gytkk/keycult-ball/docs/project-context.md

# 프로젝트 맥락과 설계 결정

작성일: 2026-10-29. 현재 저장소가 후속 작업의 기준 위치다. 대화 원문을 옮긴 문서가 아니라, 설계에 필요한 요구사항·근거·남은 질문만 정리했다.

현재 보유 제품은 사용자 확인 기준 NovelKeys 최신 판매 버전의 No.1/60 WK이며 WT60-A와 호환된다. PCB와 GH60의 호환성도 사용자 확인 완료로 두고 재확인 작업에서 제외한다. 정확한 리비전과 기존 공개 보강판 CAD의 실물 적합성은 아직 확인되지 않았다. 사용자는 외부 트랙볼을 이미 충분히 사용했으며 이번 프로젝트의 목적은 G/H 사이 중앙 통합이다. 외부 별도 장치는 후보에서 제외한다. 34mm Keyball은 현재 생성된 예비 배치의 기준이며 고정 요구사항은 아니므로 작은 볼과 터치패드도 중앙 통합 후보로 검토한다. [실현 가능성과 대안 조사](feasibility.md)는 후보 비교이며 최종 장치와 새 배열은 아직 선택하지 않았다.

## 1. 요구사항과 작업 경계

| 항목 | 현재 요구사항 / 경계 |
|---|---|
| 보존 대상 | Keycult No.1/60 케이스. 새 케이스 구멍·절삭 없이 장착하는 것이 목표 |
| 교체 대상 | 중앙 통합을 위한 PCB와 플레이트 교체 |
| 배열 | 1u=19.05mm 직교 배열, 5행을 우선 검토. 문자 순서는 QWERTY |
| 포인팅 | G/H 사이 중앙 통합 필수. 현재 예비 배치는 34mm Keyball 기준이며 작은 볼과 터치패드도 검토 가능. 트랙볼을 사용하면 볼과 센서의 상대 광학 위치 유지 |
| 연결·펌웨어 | 유선 USB, QMK 기반 키보드+포인팅 장치. 외부 별도 장치와 무선은 현재 범위 밖 |
| 현재 산출물 | 출처 있는 예비 배치, 키 중심 좌표, 평면/단면 그림, 종이 검증 및 [65키·62키 KiCad 회로·PCB 초안](../design/pcb/README.md), 각 배열의 BOM·핀맵·실제 검사 결과 |
| 아직 하지 않은 일 | 최종 회로/PCB·제조 검증, 가공용 플레이트, 검증된 펌웨어 포팅, 구매·제조·케이스 가공 |

## 2. 결정과 이유

1. **15u·중앙 3u·65키를 추천 기준안으로 유지하고 62키 옵션을 별도로 비교**한다. 하단 중앙 1u M1/M3/M2를 1.5u M1/M2로 바꾸고 M3 물리 키를 제거한다. 두 중심은 mm 단위로 M1=(-14.2875,38.1), M2=(14.2875,38.1)이며 명목 너비 합계는 3u다. 기준안은 좌우 6열씩과 중앙 3열을 배치하고 가운데 3×3칸을 비워 50mm 임시 조립 영역과 수·문자·수정키를 유지한다. `layout.json`의 `rear_clearance`는 상단 중앙 Vol-/Mute/Vol+만 제거해 중앙 빈 명목 영역을 3열 × 4행, 57.15 × 76.20mm로 늘린다. 볼 지름 34mm와 중심 `(0, 0)`, G/H x=±38.10mm, 하단 1.5u M1/M2와 나머지 키는 그대로다. 추가한 뒤쪽 19.05mm는 센서·배선, 재료를 남긴 지지 브리지와 넓은 체결 간격을 검토하기 위한 공간이다. 키 제거 자체는 강성 향상을 보증하지 않으며 전체 직사각형 절개는 오히려 강성을 낮출 수 있다. 50×50mm 임시 예약 영역과 미확정 수직 공간은 바꾸지 않는다.
2. **14u·중앙 2u·64키는 비교만 하고 보류**한다. Ø34 볼 자체는 들어가지만, 홀더/센서/나사까지 포함한 수납 근거가 없다. 50mm 예약 영역은 키캡과 5.425mm 겹친다. 실물의 높이별 외곽이 더 작으면 재검토할 수 있다.
3. **현재 생성된 예비 배치는 Keyball을 기준으로 유지**한다. 최초 검토 대상인 34mm 시스템이며 공개 조립 가이드·센서 자료를 활용할 수 있다. 공개된 센서 기판 외곽과 실제 홀더 외피는 다른 정보다. 원형 Ploopy Nano/Mini는 38.10mm, Classic은 44.45mm여서 34mm 드롭인 대체품이 아니다. Charybdis는 같은 34mm지만 별도 장착 설계가 필요하다. 제품별 센서·지지 구조·라이선스는 [별도 비교](alternatives-and-licenses.md)에 기록한다. 중앙 통합이 가능한 소형 장치는 [대안 조사](feasibility.md)에서 비교하며, 기존 산출물 유지가 최종 장치 선택을 뜻하지 않는다.
4. **볼+센서는 같은 강체에 고정**한다. 우선 새 플레이트에 하나의 모듈로 장착하고 중앙 보강을 검토한다. 공간·강성 결과에 따라 기존 케이스 체결점을 쓰는 가역 브래킷도 검토한다. 볼은 케이스, 센서는 휘는 플레이트에 따로 고정하지 않는다.
5. **GH60 공개 KiCad 도면을 출발점으로 새 PCB를 설계한다.** 보강판이 케이스에 결합하고 PCB는 스위치를 통해 지지되므로, WT60-A와의 작은 외곽 치수 차이만으로 GH60 기반 설계를 배제하지 않는다. Poker2 규격 WT60-D가 USB-C 제거와 JST 커넥터 추가 후 No.1/60에 장착된다는 제품 설명을 근거로 삼는다. WT60-A의 정확한 PCB CAD 확보를 설계 시작의 선행 조건으로 두지 않는다. 사용할 GH60 파일과 호환 근거, 도터보드 연결 조건은 [PCB 설계 출발점](../design/preliminary/design.md#pcb-설계-출발점)에 기록한다. 최종 외곽과 중앙 개구, 부품 배치 및 제조 데이터는 FreeCAD에서 공식 STEP와 실측 모듈의 기구 스택을 대조한 뒤 확정하며, 예비 SVG를 제조 DXF로 바꿔 바로 발주하지 않는다.

실측 전에 회로도, 키 매트릭스, 스위치 배치와 주요 회로 배선 초안을 진행한다. 구현 순서, RP2040 등 초안의 우선안과 단계별 완료 기준은 [PCB 구현 계획](pcb-implementation-plan.md)을 따른다. 실물 확인은 GitHub 이슈 #1부터 #6에서 관리하며, 기구와 인터페이스가 미확정인 상태를 제조 준비 완료로 보고하지 않는다.

65키 KiCad 원본은 `design/pcb/keycult65.*`, 62키 원본은 `design/pcb/62/keycult62.*`에 둔다. 공통 MCU·전원 회로는 이전 초안보다 왼쪽으로 76.2mm(4피치) 이동해 62키 뒤쪽 중앙 빈 영역을 피한다. 두 배열 모두 하단 SW59/D59를 제거하고 SW58/SW60의 중심을 옮기며, 다른 reference 번호는 유지한다. 62키에서는 SW7-SW9와 D7-D9도 제거한다. COL6과 COL8은 하단 키에 연결되고, 62키의 COL7은 키가 없으므로 GP16을 회로도에서 NC로 표시한다. 공통 15열 GPIO 순서는 유지하고 펌웨어에서는 해당 열을 KC_NO로 둔다. 스위치를 장착하지 않는 것은 전기적으로 가능하지만, 이전 PCB에는 해당 영역 아래에 공통 회로가 있으므로 기존 PCB를 잘라 공간을 확보해서는 안 된다.

65키 PCB의 부품·구리 예약 영역은 50 x 50mm다. 62키 PCB는 명목 빈 영역을 작업 외곽에 맞춰 잘라 PCB 좌표 x=151.425..208.575mm, y=52.7..128.575mm의 57.15 x 75.875mm를 예약한다. PCB 원점 대응은 배열 `(0,0)`이 `(180,100)mm`이며 +Y는 하단 방향이다. 이 영역은 홀더 치수나 중앙 Edge.Cuts 개구가 아니며, 기존 예비 도면의 50mm 임시 조립 영역과 수직 공간 가정은 유지한다. 센서는 정확한 사양을 알 수 없으므로 논리 패드로 남긴다. 검사 상태는 [65키 보고서](../design/pcb/reports/validation.json)와 [62키 보고서](../design/pcb/62/reports/validation.json)를 기준으로 한다.

USB는 [WT 호환 및 UDB 리비전별 조사](../design/pcb/sources.md#usb-daughterboard-evidence)와 2026-10-30 사용자 승인에 따라 UDB C5-JSH를 그대로 사용하는 가정으로 설계한다. 이는 보유 Keycult 순정 도터보드의 리비전이나 회로를 실측으로 확인했다는 뜻이 아니다. DRAFT E도 외부 조립체 DB1을 회로도에만 표시하며 메인 PCB footprint를 두지 않는다. C5-JSH의 CC 5.1kΩ 저항 2개, TPD4E05U06 ESD 보호, ASMD1206-150 PTC, SMF6.0A TVS 및 실드의 GND 직결을 외부 보드가 담당한다. 메인 PCB의 F1 500mA와 USB 27Ω 직렬 저항, 기존 공통 부품 배치를 유지하고 하단 1.5u M1/M2 좌표에 맞춰 매트릭스를 다시 배선한다. J1 측 USB 배선 규칙과 접지 귀환 경로도 적용한다.

두 PCB의 J1은 JST SM04B-SRSS-TB(LF)(SN)이며 핀은 1=VBUS_USB(외부 PTC 이후), 2=D-, 3=D+, 4=GND다. 케이블은 번호 기준 1:1 연결이다. J1은 하단면에서 왼쪽을 향하며 원점은 PCB `(40.6,112.0)mm`다. 이 위치는 직교 배열의 간섭을 피한 임시 배치로, WT60-A에서 실측한 위치가 아니다. 필요한 길이의 케이블을 구할 수 있으므로 기존 케이블의 도달 거리는 설계 제약에서 제외한다. 커넥터 체결·삽입 공간, 케이스 통로·굴곡 공간과 하부 높이, 실제 부하·돌입전류 및 직렬 퓨즈의 전압 강하, USB 신호 품질은 확인해야 한다. 보유 순정 도터보드의 모델 확인을 이 가정에 따른 회로·PCB 설계의 선행 조건으로 두지 않는다.

2026-10-30 [실물 없이 수행한 전기 검토](../design/pcb/README.md#power-and-usb-desk-review)는 전체 3.3V 부하 150mA, 그중 센서 40mA를 임시 설계 예산으로 둔다. 부품 최대 소비전류나 실제 사용 가능한 전류를 보증한 값은 아니며 센서가 5V 모듈이면 별도 계산한다. DRAFT E는 JLC04161H-7628 후보의 구리·유전체 모델을 CAD에 명시하고, 긴 USB 구간을 In2.Cu에서 F.Cu로 옮겨 In1.Cu 접지를 참조하도록 한다. J1 측 데이터 배선은 선폭 0.29mm, 최소 가장자리 간격 0.2mm를 사용하며 B.Cu에는 짧은 탈출 배선만 둔다. 접지 비아와 B.Cu 접지면을 추가하고 In1.Cu 상단 경계를 확장한다. [적용한 USB 배선과 검토 한계](../design/pcb/README.md#usb-routing-findings)를 따르며, 이 모델은 제조사 승인 stackup이나 임피던스 검증 완료를 뜻하지 않는다.

## 3. 확인된 값, 유도한 값, 가정한 값

2026-10-30 [로컬 FreeCAD 보강판 초안](../design/preliminary/design.md#로컬-freecad-보강판-초안)은 공식 NoLeaf의 외곽을 유지하면서 65키·62키 PCB의 스위치 중심에 맞춰 재생성한다. 중앙 지름 40mm 개구, 48 x 48 x 3mm 프레임과 네 점의 M2 체결 검토는 자체 설계 가정이며 실물 Keyball 홀더 치수가 아니다. 62키안은 뒤쪽 센서 고정부를 위한 재료를 더 남긴다. PCB 윗면 z=-5mm와 기존 설명용 볼 중심 z=8mm를 가정하면 볼과 현재 PCB가 간섭한다. 볼을 올리거나 실제 모듈에 맞는 PCB 개구를 설계해야 하며, 이번 작업에서 KiCad의 중앙을 절개하지는 않았다. 볼과 센서는 같은 프레임에 고정하는 원칙을 유지하며 실제 홀더 고정 패턴, 광학 위치와 체결 스택은 미확정이다. 공식 형상을 포함하는 FCStd/STEP/DXF와 이미지는 `design/preliminary/sources/local/plate-study/`에만 생성한다.

| 상태 | 값 | 해석 |
|---|---|---|
| 자료 명시 | 외장 294.3×111mm, 앞 20.35mm / 뒤 35.8mm | **내부 개구부나 내부 깊이가 아님** [K1] |
| 공식 CAD에서 측정 | 플레이트 285.75×108.25×1.5mm | 108.25는 장착 탭 포함. 기본 직사각형 285.75×95.25mm [K2,K3] |
| 공개 도면의 참조 경계 | 일반 직사각형 285.75×108.25mm | 바운딩 치수만 사용하며 탭·코너·공식 윤곽은 재현하지 않음 |
| 자료 명시 | Rev.1은 플레이트 호환, 다른 케이스 부품 비호환 | WT60-A 및 USB-C daughterboard. 실제 보유 리비전은 미확정 [K1] |
| 자료/원본 확인 | 34mm 볼, 센서는 홀더 뒤쪽에 **수직 설치** | 센서 PCB를 볼 아래 수평으로 가정하면 안 됨 [B1] |
| 공개 Gerber에서 측정 | 센서 PCB 22×25mm | Keyball46 공개 2022 자료 범위. 홀더 외곽도, 전체 조립 외피도 아님 [B2] |
| 채택 기준 | 피치 19.05mm | 공식 플레이트 인접 1u 스위치에서도 확인 |
| 유도 | 15u 키필드 285.75×95.25mm; G/H x=±38.10mm | 배열의 수학적 결과이며 케이스 수납 확인은 별개 |
| 유도 | 62키 옵션의 중앙 빈 명목 영역: x=-28.575..28.575mm, y=-47.625..28.575mm | 65키 기준안의 뒤쪽에 19.05mm 한 행을 추가. 홀더 외곽이나 절개 치수가 아님 |
| 가정 | 1u 키캡 18 x 18mm, 1.5u 키캡 27.525 x 18mm, 스위치 비교 사각형 14 x 14mm | 실제 키캡 하단·클립·핀·소켓·다이오드는 미검증 |
| 임시 예약 | 중앙 50×50mm | **실측 홀더 치수·플레이트/PCB 개구 치수 아님** |
| 표시상 가정 | 외장과 키필드를 동심 정렬 | 실물 기준점·플레이트 위치·개구부 오프셋으로 등록 필요 |
| 설명용 예 | 단면의 볼 중심 c=8mm | 실제 볼 중심 높이를 선택/확인한 값이 아님 |

출처 ID와 원문 URL은 [설계 문서](../design/preliminary/design.md#출처)를 따른다. 측정값·원본 해시는 [sources](../design/preliminary/sources/README.md)에 있다.

## 4. 검증된 범위와 그 한계

- 모든 키 중심, 키 수, 피치, 키캡/스위치 비교 사각형의 쌍별 충돌, 볼–키 거리, 50mm 예약 영역–키 간격을 계산했다.
- 65키안은 볼–키캡 **12.10mm**, 예약 영역–키캡 **4.10mm**, 인접 키캡 **1.05mm**의 최소 평면 간격이다.
- 62키 옵션도 공개 평면 검사와 별도 1:1 A3 인쇄 자료로 비교한다. 과거 공식 윤곽 검사 기록은 이 새 옵션을 검증한 결과가 아니며, 장착 안정성과 실제 수납은 미확정이다.
- **현재 공개 검증**은 285.75×108.25mm 일반 직사각형 치수 경계 내 포함과 부품 간 평면 간격을 다룬다. 이 직사각형은 공식 플레이트 형상이 아니므로 탭·둥근 모서리에서의 실제 포함 관계를 증명하지 않는다.
- **과거 공식 윤곽 관측**은 [plate-containment.json](../design/preliminary/plate-containment.json)에 수치 기록으로 남겼다. 당시 66키안의 스위치 비교 사각형과 키캡은 모두 공식 DXF 윤곽 안에 있었고, 키캡–윤곽 최소는 모서리에서 **약 0.327mm**였다. 현재 공개 검증이 이 결과를 다시 계산하는 것은 아니다. 공식 DXF를 로컬 취득한 뒤 `uv run scripts/verify_official_contour.py`로 별도 재현하며, 정확한 좌표·재검사 출력은 Git에서 제외하는 `design/preliminary/sources/local/`에 저장한다.
- **직사각형 경계 포함 ≠ 정확한 플레이트 윤곽 포함 ≠ 케이스 개구부 통과 ≠ 조립 가능 ≠ 제조 검증 완료**다.
- 인쇄 PDF의 100mm 기준선은 내부 벡터로 검증했다. 프린터에서는 100% 실제 크기 출력 후 자로 재확인한다.

## 5. 다음 단계: 실측 기록표

실측 전에는 빈칸을 추정값으로 채우지 않는다. 좌표는 플레이트 기준점과 방향을 함께 기록한다.

| 필요 항목 | 값 / 기록 | 결정에 미치는 영향 |
|---|---|---|
| 케이스 정확한 리비전 및 현재 PCB/플레이트 모델 | NovelKeys 최신 판매 버전, WK 및 WT60-A 호환은 사용자 확인. 정확한 리비전과 PCB/플레이트 모델은 미확정 | 정렬·탭·도터보드 호환 |
| 내부 개구부 W/H, 네 코너 반경, 턱, 중심 오프셋 | 미측정 | 15u/14u, 끝 키·키캡 통과 |
| 중앙 및 주변 플레이트 윗면→바닥/리브/나사/무게추 거리 | 미측정 | 볼 하단·홀더·PCB·배선 수납 |
| 실제 키캡 하단·최대 스트로크 외곽 | 미측정 | 현재 1u/1.5u 키캡 평면 가정의 유효성 |
| Keyball 홀더 정확한 리비전, 최대 XY, 체결부·플랜지 | 미측정 | 중앙 3u 영역과 개구 설계 |
| 볼 중심 Z, 홀더 전체 높이, 센서/렌즈/커넥터 돌출 | 미측정 | 높이별 충돌, 광학 위치 |
| 모듈 장착 홀 좌표와 조립/분해 경로 | 미측정 | 플레이트/브래킷 설계 |
| 도터보드 장착·커넥터·케이블 굴곡 | UDB C5-JSH를 그대로 사용하고 적절한 길이의 1:1 케이블을 쓰는 사용자 승인 가정. 보유 순정 도터보드의 실측 확인은 아님 | 케이스 장착, 커넥터 체결·도통, 삽입·굴곡 공간과 하부 높이 확인. 부하·돌입전류, 직렬 퓨즈 전압 강하 및 USB 신호 품질 검토 |
| 플레이트 최대 하향 휨과 볼 조작 시 상대 변위 | 시제품 필요 | 바닥 여유·보강·센서 안정성 |

### 실물 확인과 최종 확정 순서

아래는 실측 이후의 기구 확정 순서다. 회로도와 PCB 초안은 이 순서와 독립적으로 [PCB 구현 계획](pcb-implementation-plan.md)에 따라 먼저 진행한다.

1. 위 치수와 리비전을 확보한다.
2. 65키 기준안과 62키 옵션의 A3 1:1 종이 배치를 실제 플레이트에 맞춰 G/H 간격·손가락 접근을 확인한다. 뒤쪽 확보 공간은 센서·배선 및 지지체의 실제 외곽과 대조한다.
3. 실제 홀더의 STEP 또는 실측 모형으로 FreeCAD 합본 간섭 검사를 한다. 동일 강체의 센서·볼 광학 간격을 보존한다.
4. 플레이트 마운트 / 기존 체결점 브래킷 중 가능한 구조를 선택하고 휨·조립 경로를 확인한다.
5. 채택한 C5-JSH의 기구 적합성과 전원·USB 신호 품질을 검증하고 MCU/센서 전압·로직을 확정한다. 실제 핫스왑 소켓 채택 여부도 수직 여유를 보고 결정한다.
6. GH60 도면을 바탕으로 시작한 KiCad 회로/PCB의 외곽과 부품 배치를 확정하고, 실제 개구·체결 도면, QMK 포팅 및 제조 검토를 진행한다.

## 6. 자료 관리

이 저장소에 들어 있는 것은 검토 가능한 설계 맥락과 독립 레이아웃 산출물이다. 원본 대화·개인 메모·실행 환경 인증 정보는 옮기지 않았다. 원본 CAD/센서 파일은 출처·해시와 로컬 다운로드 스크립트로 참조한다. 공개 SVG/HTML/PNG/PDF에는 공식 윤곽 대신 일반 직사각형 치수 경계만 넣는다. 정확한 윤곽 좌표 `design/preliminary/sources/local/measured-official-dxf.json`과 재검사 출력은 Git에서 제외한다. 형상을 복제하지 않는 STEP 바운딩 치수 요약과 과거 윤곽 검사의 수치 기록은 공개한다. 로컬 원본 사용도 Keycult 조건을 따르며, [라이선스 비교](alternatives-and-licenses.md)를 확인한다.
