gytkk/keycult-ball/design/preliminary/layout.html

# Keycult No.1/60 + 중앙 34mm Keyball · 65키 예비안

1u = 19.05mm · 15열 × 5행 · 중앙 3 × 3칸 확보 · G(-38.10, 0) / H(+38.10, 0)

제작 도면 아님. 케이스 내부 개구부, 홀더 조립 치수, 플레이트–바닥 거리 미확정. 외장 높이를 내부 여유로 사용하지 않았습니다.

근거·설계 설명 · 키 중심 JSON · 수치 검증 · 1:1 인쇄용

청색: 볼 최대 평면 투영 Ø34. 주황색 50 × 50: 임시 조립 예약 영역이며 실제 홀더 외곽·가공 구멍이 아닙니다. 키 좌표는 키캡 안쪽 하단에 mm로 표기했습니다.

인쇄: A3 가로, 배율 100% / 실제 크기, 페이지 맞춤 끄기. 100mm 검정 기준선 실측 후 사용. A4 한 장에는 294.3mm 외장 폭과 여백을 1:1로 담기 어렵습니다.

장착 공간 대안: 15u / 중앙 3열 x 4행 / 62키

상단 중앙 Vol- / Mute / Vol+를 제거하고 뒤쪽 19.05mm를 장착 구조 검토에 사용합니다. 볼은 지름 34mm, 중심 (0, 0)을 유지합니다. 보라색 영역은 가공 구멍이 아니며 보강판 재료를 남긴 지지 구조도 검토합니다. 강성과 수직 공간은 미검증입니다.

SVG · PNG · 62키 1:1 A3 PDF

대안: 14u / 중앙 2u / 64키 — 홀더 적합성 미승인

볼만 보면 가능하지만 50mm 조립 예약 영역과 키캡이 겹칩니다. 실물 홀더·PCB·커넥터의 높이별 외곽 검증 전에는 채택하지 않습니다.
