gytkk/keycult-ball/design/pcb/gpio-map.csv

key_id | label | switch | diode | matrix_row | matrix_col | row_gpio | column_gpio | x_mm | y_mm | diode_direction
r0c0 | Esc | SW1 | D1 | 0 | 0 | GP4 | GP9 | -133.35 | -38.1 | COL2ROW
r0c1 | 1 | SW2 | D2 | 0 | 1 | GP4 | GP10 | -114.3 | -38.1 | COL2ROW
r0c2 | 2 | SW3 | D3 | 0 | 2 | GP4 | GP11 | -95.25 | -38.1 | COL2ROW
r0c3 | 3 | SW4 | D4 | 0 | 3 | GP4 | GP12 | -76.2 | -38.1 | COL2ROW
r0c4 | 4 | SW5 | D5 | 0 | 4 | GP4 | GP13 | -57.15 | -38.1 | COL2ROW
r0c5 | 5 | SW6 | D6 | 0 | 5 | GP4 | GP14 | -38.1 | -38.1 | COL2ROW
r0c6 | Vol- | SW7 | D7 | 0 | 6 | GP4 | GP15 | -19.05 | -38.1 | COL2ROW
r0c7 | Mute | SW8 | D8 | 0 | 7 | GP4 | GP16 | 0.0 | -38.1 | COL2ROW
r0c8 | Vol+ | SW9 | D9 | 0 | 8 | GP4 | GP17 | 19.05 | -38.1 | COL2ROW
r0c9 | 6 | SW10 | D10 | 0 | 9 | GP4 | GP18 | 38.1 | -38.1 | COL2ROW
r0c10 | 7 | SW11 | D11 | 0 | 10 | GP4 | GP19 | 57.15 | -38.1 | COL2ROW
r0c11 | 8 | SW12 | D12 | 0 | 11 | GP4 | GP20 | 76.2 | -38.1 | COL2ROW
r0c12 | 9 | SW13 | D13 | 0 | 12 | GP4 | GP21 | 95.25 | -38.1 | COL2ROW
r0c13 | 0 | SW14 | D14 | 0 | 13 | GP4 | GP22 | 114.3 | -38.1 | COL2ROW
r0c14 | Bksp | SW15 | D15 | 0 | 14 | GP4 | GP26 | 133.35 | -38.1 | COL2ROW
r1c0 | Tab | SW16 | D16 | 1 | 0 | GP5 | GP9 | -133.35 | -19.05 | COL2ROW
r1c1 | Q | SW17 | D17 | 1 | 1 | GP5 | GP10 | -114.3 | -19.05 | COL2ROW
r1c2 | W | SW18 | D18 | 1 | 2 | GP5 | GP11 | -95.25 | -19.05 | COL2ROW
r1c3 | E | SW19 | D19 | 1 | 3 | GP5 | GP12 | -76.2 | -19.05 | COL2ROW
r1c4 | R | SW20 | D20 | 1 | 4 | GP5 | GP13 | -57.15 | -19.05 | COL2ROW
r1c5 | T | SW21 | D21 | 1 | 5 | GP5 | GP14 | -38.1 | -19.05 | COL2ROW
r1c9 | Y | SW22 | D22 | 1 | 9 | GP5 | GP18 | 38.1 | -19.05 | COL2ROW
r1c10 | U | SW23 | D23 | 1 | 10 | GP5 | GP19 | 57.15 | -19.05 | COL2ROW
r1c11 | I | SW24 | D24 | 1 | 11 | GP5 | GP20 | 76.2 | -19.05 | COL2ROW
r1c12 | O | SW25 | D25 | 1 | 12 | GP5 | GP21 | 95.25 | -19.05 | COL2ROW
r1c13 | P | SW26 | D26 | 1 | 13 | GP5 | GP22 | 114.3 | -19.05 | COL2ROW
r1c14 | \ | SW27 | D27 | 1 | 14 | GP5 | GP26 | 133.35 | -19.05 | COL2ROW
r2c0 | Caps | SW28 | D28 | 2 | 0 | GP6 | GP9 | -133.35 | 0.0 | COL2ROW
r2c1 | A | SW29 | D29 | 2 | 1 | GP6 | GP10 | -114.3 | 0.0 | COL2ROW
r2c2 | S | SW30 | D30 | 2 | 2 | GP6 | GP11 | -95.25 | 0.0 | COL2ROW
r2c3 | D | SW31 | D31 | 2 | 3 | GP6 | GP12 | -76.2 | 0.0 | COL2ROW
r2c4 | F | SW32 | D32 | 2 | 4 | GP6 | GP13 | -57.15 | 0.0 | COL2ROW
r2c5 | G | SW33 | D33 | 2 | 5 | GP6 | GP14 | -38.1 | 0.0 | COL2ROW
r2c9 | H | SW34 | D34 | 2 | 9 | GP6 | GP18 | 38.1 | 0.0 | COL2ROW
r2c10 | J | SW35 | D35 | 2 | 10 | GP6 | GP19 | 57.15 | 0.0 | COL2ROW
r2c11 | K | SW36 | D36 | 2 | 11 | GP6 | GP20 | 76.2 | 0.0 | COL2ROW
r2c12 | L | SW37 | D37 | 2 | 12 | GP6 | GP21 | 95.25 | 0.0 | COL2ROW
r2c13 | ; | SW38 | D38 | 2 | 13 | GP6 | GP22 | 114.3 | 0.0 | COL2ROW
r2c14 | Enter | SW39 | D39 | 2 | 14 | GP6 | GP26 | 133.35 | 0.0 | COL2ROW
r3c0 | Shift | SW40 | D40 | 3 | 0 | GP7 | GP9 | -133.35 | 19.05 | COL2ROW
r3c1 | Z | SW41 | D41 | 3 | 1 | GP7 | GP10 | -114.3 | 19.05 | COL2ROW
r3c2 | X | SW42 | D42 | 3 | 2 | GP7 | GP11 | -95.25 | 19.05 | COL2ROW
r3c3 | C | SW43 | D43 | 3 | 3 | GP7 | GP12 | -76.2 | 19.05 | COL2ROW
r3c4 | V | SW44 | D44 | 3 | 4 | GP7 | GP13 | -57.15 | 19.05 | COL2ROW
r3c5 | B | SW45 | D45 | 3 | 5 | GP7 | GP14 | -38.1 | 19.05 | COL2ROW
r3c9 | N | SW46 | D46 | 3 | 9 | GP7 | GP18 | 38.1 | 19.05 | COL2ROW
r3c10 | M | SW47 | D47 | 3 | 10 | GP7 | GP19 | 57.15 | 19.05 | COL2ROW
r3c11 | , | SW48 | D48 | 3 | 11 | GP7 | GP20 | 76.2 | 19.05 | COL2ROW
r3c12 | . | SW49 | D49 | 3 | 12 | GP7 | GP21 | 95.25 | 19.05 | COL2ROW
r3c13 | / | SW50 | D50 | 3 | 13 | GP7 | GP22 | 114.3 | 19.05 | COL2ROW
r3c14 | Shift | SW51 | D51 | 3 | 14 | GP7 | GP26 | 133.35 | 19.05 | COL2ROW
r4c0 | Ctrl | SW52 | D52 | 4 | 0 | GP8 | GP9 | -133.35 | 38.1 | COL2ROW
r4c1 | GUI | SW53 | D53 | 4 | 1 | GP8 | GP10 | -114.3 | 38.1 | COL2ROW
r4c2 | Alt | SW54 | D54 | 4 | 2 | GP8 | GP11 | -95.25 | 38.1 | COL2ROW
r4c3 | Fn | SW55 | D55 | 4 | 3 | GP8 | GP12 | -76.2 | 38.1 | COL2ROW
r4c4 | Space | SW56 | D56 | 4 | 4 | GP8 | GP13 | -57.15 | 38.1 | COL2ROW
r4c5 | Del | SW57 | D57 | 4 | 5 | GP8 | GP14 | -38.1 | 38.1 | COL2ROW
r4c6 | M1 | SW58 | D58 | 4 | 6 | GP8 | GP15 | -14.2875 | 38.1 | COL2ROW
r4c8 | M2 | SW60 | D60 | 4 | 8 | GP8 | GP17 | 14.2875 | 38.1 | COL2ROW
r4c9 | Bksp | SW61 | D61 | 4 | 9 | GP8 | GP18 | 38.1 | 38.1 | COL2ROW
r4c10 | Space | SW62 | D62 | 4 | 10 | GP8 | GP19 | 57.15 | 38.1 | COL2ROW
r4c11 | Fn | SW63 | D63 | 4 | 11 | GP8 | GP20 | 76.2 | 38.1 | COL2ROW
r4c12 | Left | SW64 | D64 | 4 | 12 | GP8 | GP21 | 95.25 | 38.1 | COL2ROW
r4c13 | Down | SW65 | D65 | 4 | 13 | GP8 | GP22 | 114.3 | 38.1 | COL2ROW
r4c14 | Right | SW66 | D66 | 4 | 14 | GP8 | GP26 | 133.35 | 38.1 | COL2ROW
