gytkk/keycult-ball/design/pcb/62/exports/mcu-schematic-detail.png

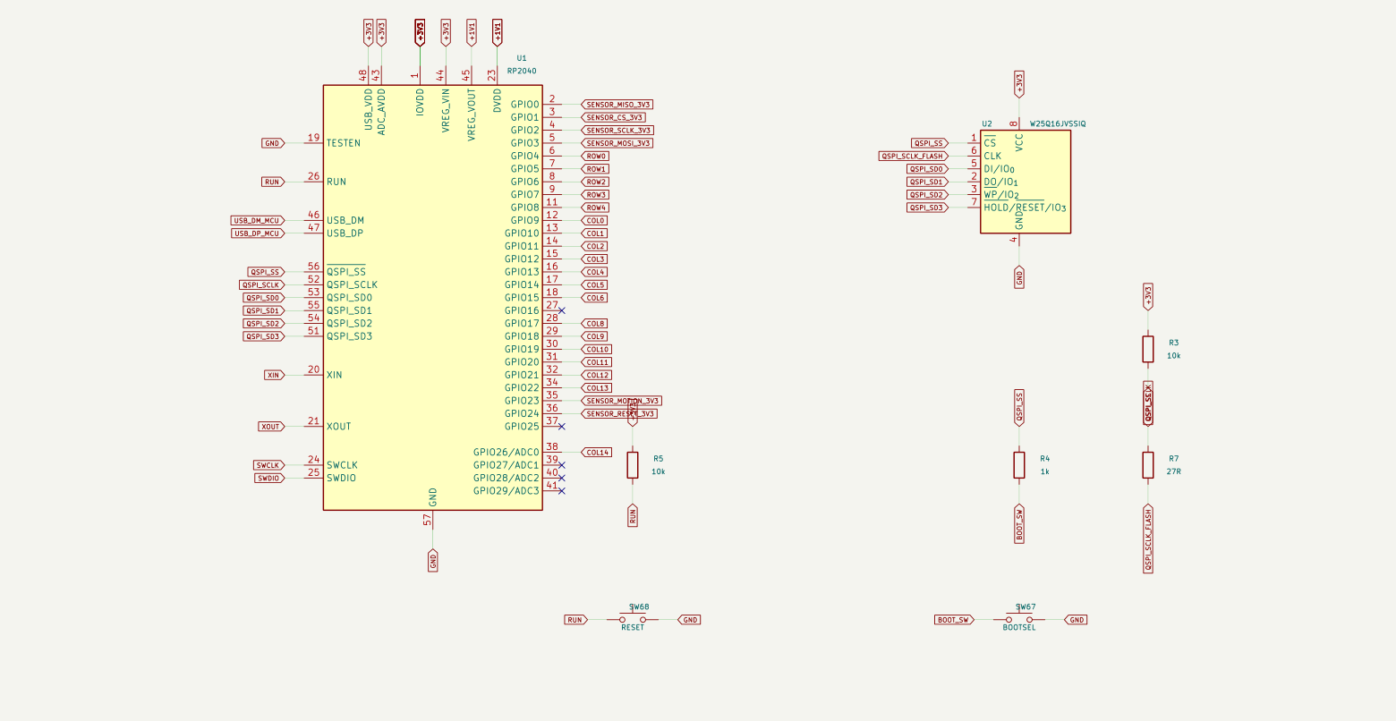
design/pcb/62/exports/mcu-schematic-detail.png
