gytkk/keycult-ball/design/pcb/62/exports/schematic-preview.png

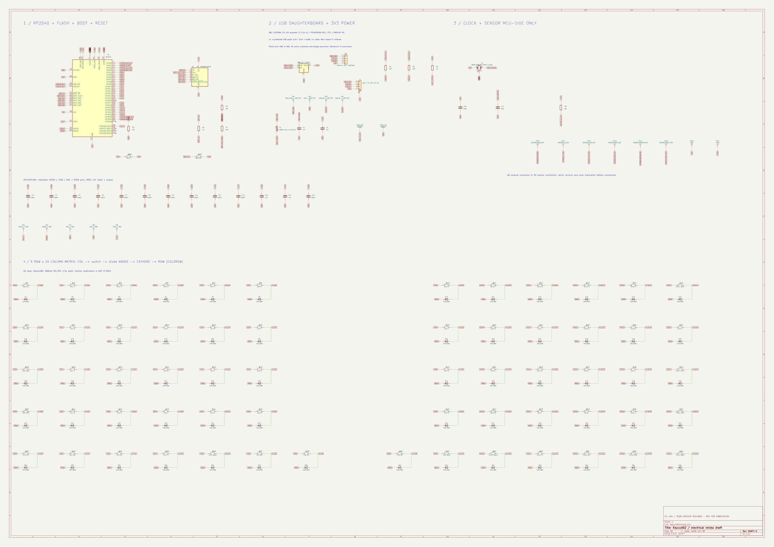
design/pcb/62/exports/schematic-preview.png
