gytkk/keycult-ball/design/preliminary/section.png

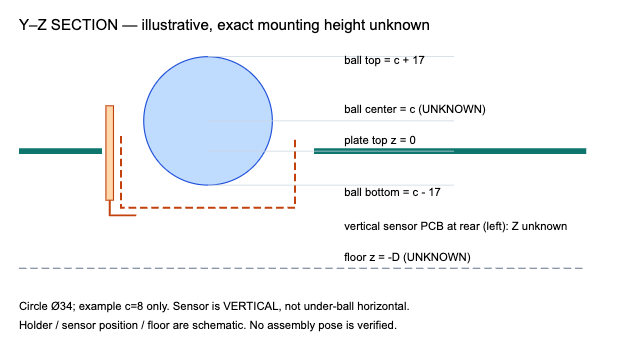
design/preliminary/section.png
