gytkk/keycult-ball/design/pcb/bom.csv

Reference | Value | Manufacturer part / candidate | Footprint | Assembly | Status | Notes
U1 | RP2040 | RP2040 | Package_DFN_QFN:QFN-56-1EP_7x7mm_P0.4mm_EP3.2x3.2mm | Bottom SMT | provisional sourcing | Direct mounted QFN; exposed pad to GND; unused GP25/27/28/29 NC
U2 | W25Q16JVSSIQ | W25Q16JVSSIQ | Package_SO:SOIC-8_5.3x5.3mm_P1.27mm | Bottom SMT | provisional sourcing | 208 mil SOIC, NOT 150mil package; QMK RP2040 flash boot stage must match
U3 | AP2112K-3.3TRG1 | AP2112K-3.3TRG1 | Package_TO_SOT_SMD:SOT-23-5 | Bottom SMT | provisional sourcing | 600mA part rating is NOT USB budget; 5V->3V3 thermal/load budget unresolved
J1 | USB / C5-JSH JST-SH | JST SM04B-SRSS-TB(LF)(SN) | Connector_JST:JST_SH_SM04B-SRSS-TB_1x04-1MP_P1.00mm_Horizontal | Bottom SMT | C5-JSH interface selected; mechanical fit provisional | 1 protected USB power, 2 D-, 3 D+, 4 GND; 1:1 JST-SH cable of suitable length. External DB1 supplies CC/ESD/PTC/TVS; VBUS_USB is after its PTC and before main-board F1
DB1 | UDB C5-JSH / EXTERNAL | Unified Daughterboard C5-JSH |  | External assembly | user-approved design assumption; external assembly | Pinned 2b6c52aa2de6f9f60ca99c6250e4bdf01e8f4eea; 5.1k CC, TPD4E05U06DQAR ESD, ASMD1206-150 PTC, SMF6.0A TVS, direct shield/GND connection; no active sustained-overvoltage disconnect; not fitted on main PCB
TP1 | VBUS_USB / USB TEST | PCB pad | TestPoint:TestPoint_Pad_D1.5mm | Bottom SMT | test access; J1 is the cable connector | Test-pad numbering differs from J1 contact numbering
TP2 | GND / USB TEST | PCB pad | TestPoint:TestPoint_Pad_D1.5mm | Bottom SMT | test access; J1 is the cable connector | Test-pad numbering differs from J1 contact numbering
TP3 | USB_DM / USB TEST | PCB pad | TestPoint:TestPoint_Pad_D1.5mm | Bottom SMT | test access; J1 is the cable connector | Test-pad numbering differs from J1 contact numbering
TP4 | USB_DP / USB TEST | PCB pad | TestPoint:TestPoint_Pad_D1.5mm | Bottom SMT | test access; J1 is the cable connector | Test-pad numbering differs from J1 contact numbering
F1 | 500mA hold / provisional | Bourns MF-PSMF050X-2 | Fuse:Fuse_0805_2012Metric | Bottom SMT | provisional sourcing | Retained local main-board PTC after C5-JSH PTC; total drop, load/inrush and trip coordination need verification; not a USB current entitlement
C1 | 1uF | TBD X7R 10V | Capacitor_SMD:C_0603_1608Metric | Bottom SMT | provisional sourcing | voltage rating >=10V; capacitance under DC bias to verify
C2 | 1uF | TBD X7R 10V | Capacitor_SMD:C_0603_1608Metric | Bottom SMT | provisional sourcing | voltage rating >=10V; capacitance under DC bias to verify
C3 | 100nF | TBD X7R 10V | Capacitor_SMD:C_0402_1005Metric | Bottom SMT | provisional sourcing | voltage rating >=10V; capacitance under DC bias to verify; IOVDD1
C4 | 100nF | TBD X7R 10V | Capacitor_SMD:C_0402_1005Metric | Bottom SMT | provisional sourcing | voltage rating >=10V; capacitance under DC bias to verify; IOVDD10
C5 | 100nF | TBD X7R 10V | Capacitor_SMD:C_0402_1005Metric | Bottom SMT | provisional sourcing | voltage rating >=10V; capacitance under DC bias to verify; IOVDD22
C6 | 100nF | TBD X7R 10V | Capacitor_SMD:C_0402_1005Metric | Bottom SMT | provisional sourcing | voltage rating >=10V; capacitance under DC bias to verify; IOVDD33
C7 | 100nF | TBD X7R 10V | Capacitor_SMD:C_0402_1005Metric | Bottom SMT | provisional sourcing | voltage rating >=10V; capacitance under DC bias to verify; IOVDD42
C8 | 100nF | TBD X7R 10V | Capacitor_SMD:C_0402_1005Metric | Bottom SMT | provisional sourcing | voltage rating >=10V; capacitance under DC bias to verify; IOVDD49
C9 | 100nF | TBD X7R 10V | Capacitor_SMD:C_0402_1005Metric | Bottom SMT | provisional sourcing | voltage rating >=10V; capacitance under DC bias to verify; ADC_AVDD43
C10 | 100nF | TBD X7R 10V | Capacitor_SMD:C_0402_1005Metric | Bottom SMT | provisional sourcing | voltage rating >=10V; capacitance under DC bias to verify; USB_VDD48
C11 | 100nF | TBD X7R 10V | Capacitor_SMD:C_0402_1005Metric | Bottom SMT | provisional sourcing | voltage rating >=10V; capacitance under DC bias to verify; DVDD23
C12 | 100nF | TBD X7R 10V | Capacitor_SMD:C_0402_1005Metric | Bottom SMT | provisional sourcing | voltage rating >=10V; capacitance under DC bias to verify; DVDD50
C13 | 1uF | TBD X7R 10V | Capacitor_SMD:C_0402_1005Metric | Bottom SMT | provisional sourcing | voltage rating >=10V; capacitance under DC bias to verify; VREG_VIN44
C14 | 1uF | TBD X7R 10V | Capacitor_SMD:C_0402_1005Metric | Bottom SMT | provisional sourcing | voltage rating >=10V; capacitance under DC bias to verify; VREG_VOUT45
C15 | 100nF | TBD X7R 10V | Capacitor_SMD:C_0402_1005Metric | Bottom SMT | provisional sourcing | voltage rating >=10V; capacitance under DC bias to verify; QSPI flash VCC
R1 | 27R | TBD 0402 1% 50V | Resistor_SMD:R_0402_1005Metric | Bottom SMT | provisional sourcing | value fixed; manufacturer not selected
R2 | 27R | TBD 0402 1% 50V | Resistor_SMD:R_0402_1005Metric | Bottom SMT | provisional sourcing | value fixed; manufacturer not selected
R3 | 10k | TBD 0402 1% 50V | Resistor_SMD:R_0402_1005Metric | Bottom SMT | provisional sourcing | value fixed; manufacturer not selected
R4 | 1k | TBD 0402 1% 50V | Resistor_SMD:R_0402_1005Metric | Bottom SMT | provisional sourcing | value fixed; manufacturer not selected
R5 | 10k | TBD 0402 1% 50V | Resistor_SMD:R_0402_1005Metric | Bottom SMT | provisional sourcing | value fixed; manufacturer not selected
R6 | 1k | TBD 0402 1% 50V | Resistor_SMD:R_0402_1005Metric | Bottom SMT | provisional sourcing | value fixed; manufacturer not selected
R7 | 27R | TBD 0402 1% 50V | Resistor_SMD:R_0402_1005Metric | Bottom SMT | provisional sourcing | value fixed; manufacturer not selected
Y1 | ABM8-272-T3 12MHz CL10pF | ABM8-272-T3 | Crystal:Crystal_SMD_3225-4Pin_3.2x2.5mm | Bottom SMT | provisional sourcing | Confirm ESR/drive/startup on assembled board
C16 | 15pF | TBD C0G 50V | Capacitor_SMD:C_0402_1005Metric | Bottom SMT | provisional sourcing | voltage rating >=10V; capacitance under DC bias to verify
C17 | 15pF | TBD C0G 50V | Capacitor_SMD:C_0402_1005Metric | Bottom SMT | provisional sourcing | voltage rating >=10V; capacitance under DC bias to verify
SW67 | BOOTSEL | E-Switch TL3342F160QG | Button_Switch_SMD:SW_SPST_TL3342 | Bottom SMT | provisional sourcing | Backside service access and switch height not mechanically verified
SW68 | RESET | E-Switch TL3342F160QG | Button_Switch_SMD:SW_SPST_TL3342 | Bottom SMT | provisional sourcing | Backside service access and switch height not mechanically verified
TP5 | SWCLK / SWD | PCB pad | TestPoint:TestPoint_Pad_D1.0mm | Bottom SMT | electrically defined; access provisional
TP6 | SWDIO / SWD | PCB pad | TestPoint:TestPoint_Pad_D1.0mm | Bottom SMT | electrically defined; access provisional
TP7 | RUN / SWD | PCB pad | TestPoint:TestPoint_Pad_D1.0mm | Bottom SMT | electrically defined; access provisional
TP8 | GND / SWD | PCB pad | TestPoint:TestPoint_Pad_D1.0mm | Bottom SMT | electrically defined; access provisional
TP9 | +3V3 / SWD | PCB pad | TestPoint:TestPoint_Pad_D1.0mm | Bottom SMT | electrically defined; access provisional
TP10 | SENSOR_MISO_3V3 | PCB pad | TestPoint:TestPoint_Pad_D1.0mm | Bottom SMT | 3V3 MCU-side logical pads ONLY | NO sensor connector, NO 5V sensor supply, NO approved module connection; level translation pending #2
TP11 | SENSOR_CS_3V3 | PCB pad | TestPoint:TestPoint_Pad_D1.0mm | Bottom SMT | 3V3 MCU-side logical pads ONLY | NO sensor connector, NO 5V sensor supply, NO approved module connection; level translation pending #2
TP12 | SENSOR_SCLK_3V3 | PCB pad | TestPoint:TestPoint_Pad_D1.0mm | Bottom SMT | 3V3 MCU-side logical pads ONLY | NO sensor connector, NO 5V sensor supply, NO approved module connection; level translation pending #2
TP13 | SENSOR_MOSI_3V3 | PCB pad | TestPoint:TestPoint_Pad_D1.0mm | Bottom SMT | 3V3 MCU-side logical pads ONLY | NO sensor connector, NO 5V sensor supply, NO approved module connection; level translation pending #2
TP14 | SENSOR_MOTION_3V3 | PCB pad | TestPoint:TestPoint_Pad_D1.0mm | Bottom SMT | 3V3 MCU-side logical pads ONLY | NO sensor connector, NO 5V sensor supply, NO approved module connection; level translation pending #2
TP15 | SENSOR_RESET_3V3 | PCB pad | TestPoint:TestPoint_Pad_D1.0mm | Bottom SMT | 3V3 MCU-side logical pads ONLY | NO sensor connector, NO 5V sensor supply, NO approved module connection; level translation pending #2
TP16 | GND | PCB pad | TestPoint:TestPoint_Pad_D1.0mm | Bottom SMT | 3V3 MCU-side logical pads ONLY | NO sensor connector, NO 5V sensor supply, NO approved module connection; level translation pending #2
TP17 | +3V3 | PCB pad | TestPoint:TestPoint_Pad_D1.0mm | Bottom SMT | 3V3 MCU-side logical pads ONLY | NO sensor connector, NO 5V sensor supply, NO approved module connection; level translation pending #2
R8 | 10k | TBD 0402 1% 50V | Resistor_SMD:R_0402_1005Metric | Bottom SMT | provisional sourcing | value fixed; manufacturer not selected
SW1 | r0c0 Esc | Cherry MX PCB-mount solder; exact variant TBD | Button_Switch_Keyboard:SW_Cherry_MX_1.00u_PCB | THT solder | provisional sourcing | Stock footprint origin is pin1, NOT stem; stem offset (-2.54,+5.08)mm
D1 | 1N4148W | 1N4148W | Diode_SMD:D_SOD-123 | Bottom SMT | provisional sourcing | Cathode pad1 to row; QMK COL2ROW; r0c0
SW2 | r0c1 1 | Cherry MX PCB-mount solder; exact variant TBD | Button_Switch_Keyboard:SW_Cherry_MX_1.00u_PCB | THT solder | provisional sourcing | Stock footprint origin is pin1, NOT stem; stem offset (-2.54,+5.08)mm
D2 | 1N4148W | 1N4148W | Diode_SMD:D_SOD-123 | Bottom SMT | provisional sourcing | Cathode pad1 to row; QMK COL2ROW; r0c1
SW3 | r0c2 2 | Cherry MX PCB-mount solder; exact variant TBD | Button_Switch_Keyboard:SW_Cherry_MX_1.00u_PCB | THT solder | provisional sourcing | Stock footprint origin is pin1, NOT stem; stem offset (-2.54,+5.08)mm
D3 | 1N4148W | 1N4148W | Diode_SMD:D_SOD-123 | Bottom SMT | provisional sourcing | Cathode pad1 to row; QMK COL2ROW; r0c2
SW4 | r0c3 3 | Cherry MX PCB-mount solder; exact variant TBD | Button_Switch_Keyboard:SW_Cherry_MX_1.00u_PCB | THT solder | provisional sourcing | Stock footprint origin is pin1, NOT stem; stem offset (-2.54,+5.08)mm
D4 | 1N4148W | 1N4148W | Diode_SMD:D_SOD-123 | Bottom SMT | provisional sourcing | Cathode pad1 to row; QMK COL2ROW; r0c3
SW5 | r0c4 4 | Cherry MX PCB-mount solder; exact variant TBD | Button_Switch_Keyboard:SW_Cherry_MX_1.00u_PCB | THT solder | provisional sourcing | Stock footprint origin is pin1, NOT stem; stem offset (-2.54,+5.08)mm
D5 | 1N4148W | 1N4148W | Diode_SMD:D_SOD-123 | Bottom SMT | provisional sourcing | Cathode pad1 to row; QMK COL2ROW; r0c4
SW6 | r0c5 5 | Cherry MX PCB-mount solder; exact variant TBD | Button_Switch_Keyboard:SW_Cherry_MX_1.00u_PCB | THT solder | provisional sourcing | Stock footprint origin is pin1, NOT stem; stem offset (-2.54,+5.08)mm
D6 | 1N4148W | 1N4148W | Diode_SMD:D_SOD-123 | Bottom SMT | provisional sourcing | Cathode pad1 to row; QMK COL2ROW; r0c5
SW7 | r0c6 Vol- | Cherry MX PCB-mount solder; exact variant TBD | Button_Switch_Keyboard:SW_Cherry_MX_1.00u_PCB | THT solder | provisional sourcing | Stock footprint origin is pin1, NOT stem; stem offset (-2.54,+5.08)mm
D7 | 1N4148W | 1N4148W | Diode_SMD:D_SOD-123 | Bottom SMT | provisional sourcing | Cathode pad1 to row; QMK COL2ROW; r0c6
SW8 | r0c7 Mute | Cherry MX PCB-mount solder; exact variant TBD | Button_Switch_Keyboard:SW_Cherry_MX_1.00u_PCB | THT solder | provisional sourcing | Stock footprint origin is pin1, NOT stem; stem offset (-2.54,+5.08)mm
D8 | 1N4148W | 1N4148W | Diode_SMD:D_SOD-123 | Bottom SMT | provisional sourcing | Cathode pad1 to row; QMK COL2ROW; r0c7
SW9 | r0c8 Vol+ | Cherry MX PCB-mount solder; exact variant TBD | Button_Switch_Keyboard:SW_Cherry_MX_1.00u_PCB | THT solder | provisional sourcing | Stock footprint origin is pin1, NOT stem; stem offset (-2.54,+5.08)mm
D9 | 1N4148W | 1N4148W | Diode_SMD:D_SOD-123 | Bottom SMT | provisional sourcing | Cathode pad1 to row; QMK COL2ROW; r0c8
SW10 | r0c9 6 | Cherry MX PCB-mount solder; exact variant TBD | Button_Switch_Keyboard:SW_Cherry_MX_1.00u_PCB | THT solder | provisional sourcing | Stock footprint origin is pin1, NOT stem; stem offset (-2.54,+5.08)mm
D10 | 1N4148W | 1N4148W | Diode_SMD:D_SOD-123 | Bottom SMT | provisional sourcing | Cathode pad1 to row; QMK COL2ROW; r0c9
SW11 | r0c10 7 | Cherry MX PCB-mount solder; exact variant TBD | Button_Switch_Keyboard:SW_Cherry_MX_1.00u_PCB | THT solder | provisional sourcing | Stock footprint origin is pin1, NOT stem; stem offset (-2.54,+5.08)mm
D11 | 1N4148W | 1N4148W | Diode_SMD:D_SOD-123 | Bottom SMT | provisional sourcing | Cathode pad1 to row; QMK COL2ROW; r0c10
SW12 | r0c11 8 | Cherry MX PCB-mount solder; exact variant TBD | Button_Switch_Keyboard:SW_Cherry_MX_1.00u_PCB | THT solder | provisional sourcing | Stock footprint origin is pin1, NOT stem; stem offset (-2.54,+5.08)mm
D12 | 1N4148W | 1N4148W | Diode_SMD:D_SOD-123 | Bottom SMT | provisional sourcing | Cathode pad1 to row; QMK COL2ROW; r0c11
SW13 | r0c12 9 | Cherry MX PCB-mount solder; exact variant TBD | Button_Switch_Keyboard:SW_Cherry_MX_1.00u_PCB | THT solder | provisional sourcing | Stock footprint origin is pin1, NOT stem; stem offset (-2.54,+5.08)mm
D13 | 1N4148W | 1N4148W | Diode_SMD:D_SOD-123 | Bottom SMT | provisional sourcing | Cathode pad1 to row; QMK COL2ROW; r0c12
SW14 | r0c13 0 | Cherry MX PCB-mount solder; exact variant TBD | Button_Switch_Keyboard:SW_Cherry_MX_1.00u_PCB | THT solder | provisional sourcing | Stock footprint origin is pin1, NOT stem; stem offset (-2.54,+5.08)mm
D14 | 1N4148W | 1N4148W | Diode_SMD:D_SOD-123 | Bottom SMT | provisional sourcing | Cathode pad1 to row; QMK COL2ROW; r0c13
SW15 | r0c14 Bksp | Cherry MX PCB-mount solder; exact variant TBD | Button_Switch_Keyboard:SW_Cherry_MX_1.00u_PCB | THT solder | provisional sourcing | Stock footprint origin is pin1, NOT stem; stem offset (-2.54,+5.08)mm
D15 | 1N4148W | 1N4148W | Diode_SMD:D_SOD-123 | Bottom SMT | provisional sourcing | Cathode pad1 to row; QMK COL2ROW; r0c14
SW16 | r1c0 Tab | Cherry MX PCB-mount solder; exact variant TBD | Button_Switch_Keyboard:SW_Cherry_MX_1.00u_PCB | THT solder | provisional sourcing | Stock footprint origin is pin1, NOT stem; stem offset (-2.54,+5.08)mm
D16 | 1N4148W | 1N4148W | Diode_SMD:D_SOD-123 | Bottom SMT | provisional sourcing | Cathode pad1 to row; QMK COL2ROW; r1c0
SW17 | r1c1 Q | Cherry MX PCB-mount solder; exact variant TBD | Button_Switch_Keyboard:SW_Cherry_MX_1.00u_PCB | THT solder | provisional sourcing | Stock footprint origin is pin1, NOT stem; stem offset (-2.54,+5.08)mm
D17 | 1N4148W | 1N4148W | Diode_SMD:D_SOD-123 | Bottom SMT | provisional sourcing | Cathode pad1 to row; QMK COL2ROW; r1c1
SW18 | r1c2 W | Cherry MX PCB-mount solder; exact variant TBD | Button_Switch_Keyboard:SW_Cherry_MX_1.00u_PCB | THT solder | provisional sourcing | Stock footprint origin is pin1, NOT stem; stem offset (-2.54,+5.08)mm
D18 | 1N4148W | 1N4148W | Diode_SMD:D_SOD-123 | Bottom SMT | provisional sourcing | Cathode pad1 to row; QMK COL2ROW; r1c2
SW19 | r1c3 E | Cherry MX PCB-mount solder; exact variant TBD | Button_Switch_Keyboard:SW_Cherry_MX_1.00u_PCB | THT solder | provisional sourcing | Stock footprint origin is pin1, NOT stem; stem offset (-2.54,+5.08)mm
D19 | 1N4148W | 1N4148W | Diode_SMD:D_SOD-123 | Bottom SMT | provisional sourcing | Cathode pad1 to row; QMK COL2ROW; r1c3
SW20 | r1c4 R | Cherry MX PCB-mount solder; exact variant TBD | Button_Switch_Keyboard:SW_Cherry_MX_1.00u_PCB | THT solder | provisional sourcing | Stock footprint origin is pin1, NOT stem; stem offset (-2.54,+5.08)mm
D20 | 1N4148W | 1N4148W | Diode_SMD:D_SOD-123 | Bottom SMT | provisional sourcing | Cathode pad1 to row; QMK COL2ROW; r1c4
SW21 | r1c5 T | Cherry MX PCB-mount solder; exact variant TBD | Button_Switch_Keyboard:SW_Cherry_MX_1.00u_PCB | THT solder | provisional sourcing | Stock footprint origin is pin1, NOT stem; stem offset (-2.54,+5.08)mm
D21 | 1N4148W | 1N4148W | Diode_SMD:D_SOD-123 | Bottom SMT | provisional sourcing | Cathode pad1 to row; QMK COL2ROW; r1c5
SW22 | r1c9 Y | Cherry MX PCB-mount solder; exact variant TBD | Button_Switch_Keyboard:SW_Cherry_MX_1.00u_PCB | THT solder | provisional sourcing | Stock footprint origin is pin1, NOT stem; stem offset (-2.54,+5.08)mm
D22 | 1N4148W | 1N4148W | Diode_SMD:D_SOD-123 | Bottom SMT | provisional sourcing | Cathode pad1 to row; QMK COL2ROW; r1c9
SW23 | r1c10 U | Cherry MX PCB-mount solder; exact variant TBD | Button_Switch_Keyboard:SW_Cherry_MX_1.00u_PCB | THT solder | provisional sourcing | Stock footprint origin is pin1, NOT stem; stem offset (-2.54,+5.08)mm
D23 | 1N4148W | 1N4148W | Diode_SMD:D_SOD-123 | Bottom SMT | provisional sourcing | Cathode pad1 to row; QMK COL2ROW; r1c10
SW24 | r1c11 I | Cherry MX PCB-mount solder; exact variant TBD | Button_Switch_Keyboard:SW_Cherry_MX_1.00u_PCB | THT solder | provisional sourcing | Stock footprint origin is pin1, NOT stem; stem offset (-2.54,+5.08)mm
D24 | 1N4148W | 1N4148W | Diode_SMD:D_SOD-123 | Bottom SMT | provisional sourcing | Cathode pad1 to row; QMK COL2ROW; r1c11
SW25 | r1c12 O | Cherry MX PCB-mount solder; exact variant TBD | Button_Switch_Keyboard:SW_Cherry_MX_1.00u_PCB | THT solder | provisional sourcing | Stock footprint origin is pin1, NOT stem; stem offset (-2.54,+5.08)mm
D25 | 1N4148W | 1N4148W | Diode_SMD:D_SOD-123 | Bottom SMT | provisional sourcing | Cathode pad1 to row; QMK COL2ROW; r1c12
SW26 | r1c13 P | Cherry MX PCB-mount solder; exact variant TBD | Button_Switch_Keyboard:SW_Cherry_MX_1.00u_PCB | THT solder | provisional sourcing | Stock footprint origin is pin1, NOT stem; stem offset (-2.54,+5.08)mm
D26 | 1N4148W | 1N4148W | Diode_SMD:D_SOD-123 | Bottom SMT | provisional sourcing | Cathode pad1 to row; QMK COL2ROW; r1c13
SW27 | r1c14 \ | Cherry MX PCB-mount solder; exact variant TBD | Button_Switch_Keyboard:SW_Cherry_MX_1.00u_PCB | THT solder | provisional sourcing | Stock footprint origin is pin1, NOT stem; stem offset (-2.54,+5.08)mm
D27 | 1N4148W | 1N4148W | Diode_SMD:D_SOD-123 | Bottom SMT | provisional sourcing | Cathode pad1 to row; QMK COL2ROW; r1c14
SW28 | r2c0 Caps | Cherry MX PCB-mount solder; exact variant TBD | Button_Switch_Keyboard:SW_Cherry_MX_1.00u_PCB | THT solder | provisional sourcing | Stock footprint origin is pin1, NOT stem; stem offset (-2.54,+5.08)mm
D28 | 1N4148W | 1N4148W | Diode_SMD:D_SOD-123 | Bottom SMT | provisional sourcing | Cathode pad1 to row; QMK COL2ROW; r2c0
SW29 | r2c1 A | Cherry MX PCB-mount solder; exact variant TBD | Button_Switch_Keyboard:SW_Cherry_MX_1.00u_PCB | THT solder | provisional sourcing | Stock footprint origin is pin1, NOT stem; stem offset (-2.54,+5.08)mm
D29 | 1N4148W | 1N4148W | Diode_SMD:D_SOD-123 | Bottom SMT | provisional sourcing | Cathode pad1 to row; QMK COL2ROW; r2c1
SW30 | r2c2 S | Cherry MX PCB-mount solder; exact variant TBD | Button_Switch_Keyboard:SW_Cherry_MX_1.00u_PCB | THT solder | provisional sourcing | Stock footprint origin is pin1, NOT stem; stem offset (-2.54,+5.08)mm
D30 | 1N4148W | 1N4148W | Diode_SMD:D_SOD-123 | Bottom SMT | provisional sourcing | Cathode pad1 to row; QMK COL2ROW; r2c2
SW31 | r2c3 D | Cherry MX PCB-mount solder; exact variant TBD | Button_Switch_Keyboard:SW_Cherry_MX_1.00u_PCB | THT solder | provisional sourcing | Stock footprint origin is pin1, NOT stem; stem offset (-2.54,+5.08)mm
D31 | 1N4148W | 1N4148W | Diode_SMD:D_SOD-123 | Bottom SMT | provisional sourcing | Cathode pad1 to row; QMK COL2ROW; r2c3
SW32 | r2c4 F | Cherry MX PCB-mount solder; exact variant TBD | Button_Switch_Keyboard:SW_Cherry_MX_1.00u_PCB | THT solder | provisional sourcing | Stock footprint origin is pin1, NOT stem; stem offset (-2.54,+5.08)mm
D32 | 1N4148W | 1N4148W | Diode_SMD:D_SOD-123 | Bottom SMT | provisional sourcing | Cathode pad1 to row; QMK COL2ROW; r2c4
SW33 | r2c5 G | Cherry MX PCB-mount solder; exact variant TBD | Button_Switch_Keyboard:SW_Cherry_MX_1.00u_PCB | THT solder | provisional sourcing | Stock footprint origin is pin1, NOT stem; stem offset (-2.54,+5.08)mm
D33 | 1N4148W | 1N4148W | Diode_SMD:D_SOD-123 | Bottom SMT | provisional sourcing | Cathode pad1 to row; QMK COL2ROW; r2c5
SW34 | r2c9 H | Cherry MX PCB-mount solder; exact variant TBD | Button_Switch_Keyboard:SW_Cherry_MX_1.00u_PCB | THT solder | provisional sourcing | Stock footprint origin is pin1, NOT stem; stem offset (-2.54,+5.08)mm
D34 | 1N4148W | 1N4148W | Diode_SMD:D_SOD-123 | Bottom SMT | provisional sourcing | Cathode pad1 to row; QMK COL2ROW; r2c9
SW35 | r2c10 J | Cherry MX PCB-mount solder; exact variant TBD | Button_Switch_Keyboard:SW_Cherry_MX_1.00u_PCB | THT solder | provisional sourcing | Stock footprint origin is pin1, NOT stem; stem offset (-2.54,+5.08)mm
D35 | 1N4148W | 1N4148W | Diode_SMD:D_SOD-123 | Bottom SMT | provisional sourcing | Cathode pad1 to row; QMK COL2ROW; r2c10
SW36 | r2c11 K | Cherry MX PCB-mount solder; exact variant TBD | Button_Switch_Keyboard:SW_Cherry_MX_1.00u_PCB | THT solder | provisional sourcing | Stock footprint origin is pin1, NOT stem; stem offset (-2.54,+5.08)mm
D36 | 1N4148W | 1N4148W | Diode_SMD:D_SOD-123 | Bottom SMT | provisional sourcing | Cathode pad1 to row; QMK COL2ROW; r2c11
SW37 | r2c12 L | Cherry MX PCB-mount solder; exact variant TBD | Button_Switch_Keyboard:SW_Cherry_MX_1.00u_PCB | THT solder | provisional sourcing | Stock footprint origin is pin1, NOT stem; stem offset (-2.54,+5.08)mm
D37 | 1N4148W | 1N4148W | Diode_SMD:D_SOD-123 | Bottom SMT | provisional sourcing | Cathode pad1 to row; QMK COL2ROW; r2c12
SW38 | r2c13 ; | Cherry MX PCB-mount solder; exact variant TBD | Button_Switch_Keyboard:SW_Cherry_MX_1.00u_PCB | THT solder | provisional sourcing | Stock footprint origin is pin1, NOT stem; stem offset (-2.54,+5.08)mm
D38 | 1N4148W | 1N4148W | Diode_SMD:D_SOD-123 | Bottom SMT | provisional sourcing | Cathode pad1 to row; QMK COL2ROW; r2c13
SW39 | r2c14 Enter | Cherry MX PCB-mount solder; exact variant TBD | Button_Switch_Keyboard:SW_Cherry_MX_1.00u_PCB | THT solder | provisional sourcing | Stock footprint origin is pin1, NOT stem; stem offset (-2.54,+5.08)mm
D39 | 1N4148W | 1N4148W | Diode_SMD:D_SOD-123 | Bottom SMT | provisional sourcing | Cathode pad1 to row; QMK COL2ROW; r2c14
SW40 | r3c0 Shift | Cherry MX PCB-mount solder; exact variant TBD | Button_Switch_Keyboard:SW_Cherry_MX_1.00u_PCB | THT solder | provisional sourcing | Stock footprint origin is pin1, NOT stem; stem offset (-2.54,+5.08)mm
D40 | 1N4148W | 1N4148W | Diode_SMD:D_SOD-123 | Bottom SMT | provisional sourcing | Cathode pad1 to row; QMK COL2ROW; r3c0
SW41 | r3c1 Z | Cherry MX PCB-mount solder; exact variant TBD | Button_Switch_Keyboard:SW_Cherry_MX_1.00u_PCB | THT solder | provisional sourcing | Stock footprint origin is pin1, NOT stem; stem offset (-2.54,+5.08)mm
D41 | 1N4148W | 1N4148W | Diode_SMD:D_SOD-123 | Bottom SMT | provisional sourcing | Cathode pad1 to row; QMK COL2ROW; r3c1
SW42 | r3c2 X | Cherry MX PCB-mount solder; exact variant TBD | Button_Switch_Keyboard:SW_Cherry_MX_1.00u_PCB | THT solder | provisional sourcing | Stock footprint origin is pin1, NOT stem; stem offset (-2.54,+5.08)mm
D42 | 1N4148W | 1N4148W | Diode_SMD:D_SOD-123 | Bottom SMT | provisional sourcing | Cathode pad1 to row; QMK COL2ROW; r3c2
SW43 | r3c3 C | Cherry MX PCB-mount solder; exact variant TBD | Button_Switch_Keyboard:SW_Cherry_MX_1.00u_PCB | THT solder | provisional sourcing | Stock footprint origin is pin1, NOT stem; stem offset (-2.54,+5.08)mm
D43 | 1N4148W | 1N4148W | Diode_SMD:D_SOD-123 | Bottom SMT | provisional sourcing | Cathode pad1 to row; QMK COL2ROW; r3c3
SW44 | r3c4 V | Cherry MX PCB-mount solder; exact variant TBD | Button_Switch_Keyboard:SW_Cherry_MX_1.00u_PCB | THT solder | provisional sourcing | Stock footprint origin is pin1, NOT stem; stem offset (-2.54,+5.08)mm
D44 | 1N4148W | 1N4148W | Diode_SMD:D_SOD-123 | Bottom SMT | provisional sourcing | Cathode pad1 to row; QMK COL2ROW; r3c4
SW45 | r3c5 B | Cherry MX PCB-mount solder; exact variant TBD | Button_Switch_Keyboard:SW_Cherry_MX_1.00u_PCB | THT solder | provisional sourcing | Stock footprint origin is pin1, NOT stem; stem offset (-2.54,+5.08)mm
D45 | 1N4148W | 1N4148W | Diode_SMD:D_SOD-123 | Bottom SMT | provisional sourcing | Cathode pad1 to row; QMK COL2ROW; r3c5
SW46 | r3c9 N | Cherry MX PCB-mount solder; exact variant TBD | Button_Switch_Keyboard:SW_Cherry_MX_1.00u_PCB | THT solder | provisional sourcing | Stock footprint origin is pin1, NOT stem; stem offset (-2.54,+5.08)mm
D46 | 1N4148W | 1N4148W | Diode_SMD:D_SOD-123 | Bottom SMT | provisional sourcing | Cathode pad1 to row; QMK COL2ROW; r3c9
SW47 | r3c10 M | Cherry MX PCB-mount solder; exact variant TBD | Button_Switch_Keyboard:SW_Cherry_MX_1.00u_PCB | THT solder | provisional sourcing | Stock footprint origin is pin1, NOT stem; stem offset (-2.54,+5.08)mm
D47 | 1N4148W | 1N4148W | Diode_SMD:D_SOD-123 | Bottom SMT | provisional sourcing | Cathode pad1 to row; QMK COL2ROW; r3c10
SW48 | r3c11 , | Cherry MX PCB-mount solder; exact variant TBD | Button_Switch_Keyboard:SW_Cherry_MX_1.00u_PCB | THT solder | provisional sourcing | Stock footprint origin is pin1, NOT stem; stem offset (-2.54,+5.08)mm
D48 | 1N4148W | 1N4148W | Diode_SMD:D_SOD-123 | Bottom SMT | provisional sourcing | Cathode pad1 to row; QMK COL2ROW; r3c11
SW49 | r3c12 . | Cherry MX PCB-mount solder; exact variant TBD | Button_Switch_Keyboard:SW_Cherry_MX_1.00u_PCB | THT solder | provisional sourcing | Stock footprint origin is pin1, NOT stem; stem offset (-2.54,+5.08)mm
D49 | 1N4148W | 1N4148W | Diode_SMD:D_SOD-123 | Bottom SMT | provisional sourcing | Cathode pad1 to row; QMK COL2ROW; r3c12
SW50 | r3c13 / | Cherry MX PCB-mount solder; exact variant TBD | Button_Switch_Keyboard:SW_Cherry_MX_1.00u_PCB | THT solder | provisional sourcing | Stock footprint origin is pin1, NOT stem; stem offset (-2.54,+5.08)mm
D50 | 1N4148W | 1N4148W | Diode_SMD:D_SOD-123 | Bottom SMT | provisional sourcing | Cathode pad1 to row; QMK COL2ROW; r3c13
SW51 | r3c14 Shift | Cherry MX PCB-mount solder; exact variant TBD | Button_Switch_Keyboard:SW_Cherry_MX_1.00u_PCB | THT solder | provisional sourcing | Stock footprint origin is pin1, NOT stem; stem offset (-2.54,+5.08)mm
D51 | 1N4148W | 1N4148W | Diode_SMD:D_SOD-123 | Bottom SMT | provisional sourcing | Cathode pad1 to row; QMK COL2ROW; r3c14
SW52 | r4c0 Ctrl | Cherry MX PCB-mount solder; exact variant TBD | Button_Switch_Keyboard:SW_Cherry_MX_1.00u_PCB | THT solder | provisional sourcing | Stock footprint origin is pin1, NOT stem; stem offset (-2.54,+5.08)mm
D52 | 1N4148W | 1N4148W | Diode_SMD:D_SOD-123 | Bottom SMT | provisional sourcing | Cathode pad1 to row; QMK COL2ROW; r4c0
SW53 | r4c1 GUI | Cherry MX PCB-mount solder; exact variant TBD | Button_Switch_Keyboard:SW_Cherry_MX_1.00u_PCB | THT solder | provisional sourcing | Stock footprint origin is pin1, NOT stem; stem offset (-2.54,+5.08)mm
D53 | 1N4148W | 1N4148W | Diode_SMD:D_SOD-123 | Bottom SMT | provisional sourcing | Cathode pad1 to row; QMK COL2ROW; r4c1
SW54 | r4c2 Alt | Cherry MX PCB-mount solder; exact variant TBD | Button_Switch_Keyboard:SW_Cherry_MX_1.00u_PCB | THT solder | provisional sourcing | Stock footprint origin is pin1, NOT stem; stem offset (-2.54,+5.08)mm
D54 | 1N4148W | 1N4148W | Diode_SMD:D_SOD-123 | Bottom SMT | provisional sourcing | Cathode pad1 to row; QMK COL2ROW; r4c2
SW55 | r4c3 Fn | Cherry MX PCB-mount solder; exact variant TBD | Button_Switch_Keyboard:SW_Cherry_MX_1.00u_PCB | THT solder | provisional sourcing | Stock footprint origin is pin1, NOT stem; stem offset (-2.54,+5.08)mm
D55 | 1N4148W | 1N4148W | Diode_SMD:D_SOD-123 | Bottom SMT | provisional sourcing | Cathode pad1 to row; QMK COL2ROW; r4c3
SW56 | r4c4 Space | Cherry MX PCB-mount solder; exact variant TBD | Button_Switch_Keyboard:SW_Cherry_MX_1.00u_PCB | THT solder | provisional sourcing | Stock footprint origin is pin1, NOT stem; stem offset (-2.54,+5.08)mm
D56 | 1N4148W | 1N4148W | Diode_SMD:D_SOD-123 | Bottom SMT | provisional sourcing | Cathode pad1 to row; QMK COL2ROW; r4c4
SW57 | r4c5 Del | Cherry MX PCB-mount solder; exact variant TBD | Button_Switch_Keyboard:SW_Cherry_MX_1.00u_PCB | THT solder | provisional sourcing | Stock footprint origin is pin1, NOT stem; stem offset (-2.54,+5.08)mm
D57 | 1N4148W | 1N4148W | Diode_SMD:D_SOD-123 | Bottom SMT | provisional sourcing | Cathode pad1 to row; QMK COL2ROW; r4c5
SW58 | r4c6 M1 | Cherry MX PCB-mount solder; exact variant TBD | Button_Switch_Keyboard:SW_Cherry_MX_1.50u_PCB | THT solder | provisional sourcing | Stock footprint origin is pin1, NOT stem; stem offset (-2.54,+5.08)mm
D58 | 1N4148W | 1N4148W | Diode_SMD:D_SOD-123 | Bottom SMT | provisional sourcing | Cathode pad1 to row; QMK COL2ROW; r4c6
SW60 | r4c8 M2 | Cherry MX PCB-mount solder; exact variant TBD | Button_Switch_Keyboard:SW_Cherry_MX_1.50u_PCB | THT solder | provisional sourcing | Stock footprint origin is pin1, NOT stem; stem offset (-2.54,+5.08)mm
D60 | 1N4148W | 1N4148W | Diode_SMD:D_SOD-123 | Bottom SMT | provisional sourcing | Cathode pad1 to row; QMK COL2ROW; r4c8
SW61 | r4c9 Bksp | Cherry MX PCB-mount solder; exact variant TBD | Button_Switch_Keyboard:SW_Cherry_MX_1.00u_PCB | THT solder | provisional sourcing | Stock footprint origin is pin1, NOT stem; stem offset (-2.54,+5.08)mm
D61 | 1N4148W | 1N4148W | Diode_SMD:D_SOD-123 | Bottom SMT | provisional sourcing | Cathode pad1 to row; QMK COL2ROW; r4c9
SW62 | r4c10 Space | Cherry MX PCB-mount solder; exact variant TBD | Button_Switch_Keyboard:SW_Cherry_MX_1.00u_PCB | THT solder | provisional sourcing | Stock footprint origin is pin1, NOT stem; stem offset (-2.54,+5.08)mm
D62 | 1N4148W | 1N4148W | Diode_SMD:D_SOD-123 | Bottom SMT | provisional sourcing | Cathode pad1 to row; QMK COL2ROW; r4c10
SW63 | r4c11 Fn | Cherry MX PCB-mount solder; exact variant TBD | Button_Switch_Keyboard:SW_Cherry_MX_1.00u_PCB | THT solder | provisional sourcing | Stock footprint origin is pin1, NOT stem; stem offset (-2.54,+5.08)mm
D63 | 1N4148W | 1N4148W | Diode_SMD:D_SOD-123 | Bottom SMT | provisional sourcing | Cathode pad1 to row; QMK COL2ROW; r4c11
SW64 | r4c12 Left | Cherry MX PCB-mount solder; exact variant TBD | Button_Switch_Keyboard:SW_Cherry_MX_1.00u_PCB | THT solder | provisional sourcing | Stock footprint origin is pin1, NOT stem; stem offset (-2.54,+5.08)mm
D64 | 1N4148W | 1N4148W | Diode_SMD:D_SOD-123 | Bottom SMT | provisional sourcing | Cathode pad1 to row; QMK COL2ROW; r4c12
SW65 | r4c13 Down | Cherry MX PCB-mount solder; exact variant TBD | Button_Switch_Keyboard:SW_Cherry_MX_1.00u_PCB | THT solder | provisional sourcing | Stock footprint origin is pin1, NOT stem; stem offset (-2.54,+5.08)mm
D65 | 1N4148W | 1N4148W | Diode_SMD:D_SOD-123 | Bottom SMT | provisional sourcing | Cathode pad1 to row; QMK COL2ROW; r4c13
SW66 | r4c14 Right | Cherry MX PCB-mount solder; exact variant TBD | Button_Switch_Keyboard:SW_Cherry_MX_1.00u_PCB | THT solder | provisional sourcing | Stock footprint origin is pin1, NOT stem; stem offset (-2.54,+5.08)mm
D66 | 1N4148W | 1N4148W | Diode_SMD:D_SOD-123 | Bottom SMT | provisional sourcing | Cathode pad1 to row; QMK COL2ROW; r4c14
