gytkk/keycult-ball/design/preliminary/print-1to1.pdf

Actual size / 100%. Verify the 100mm line with a ruler. Preliminary layout only; not fabrication CAD.

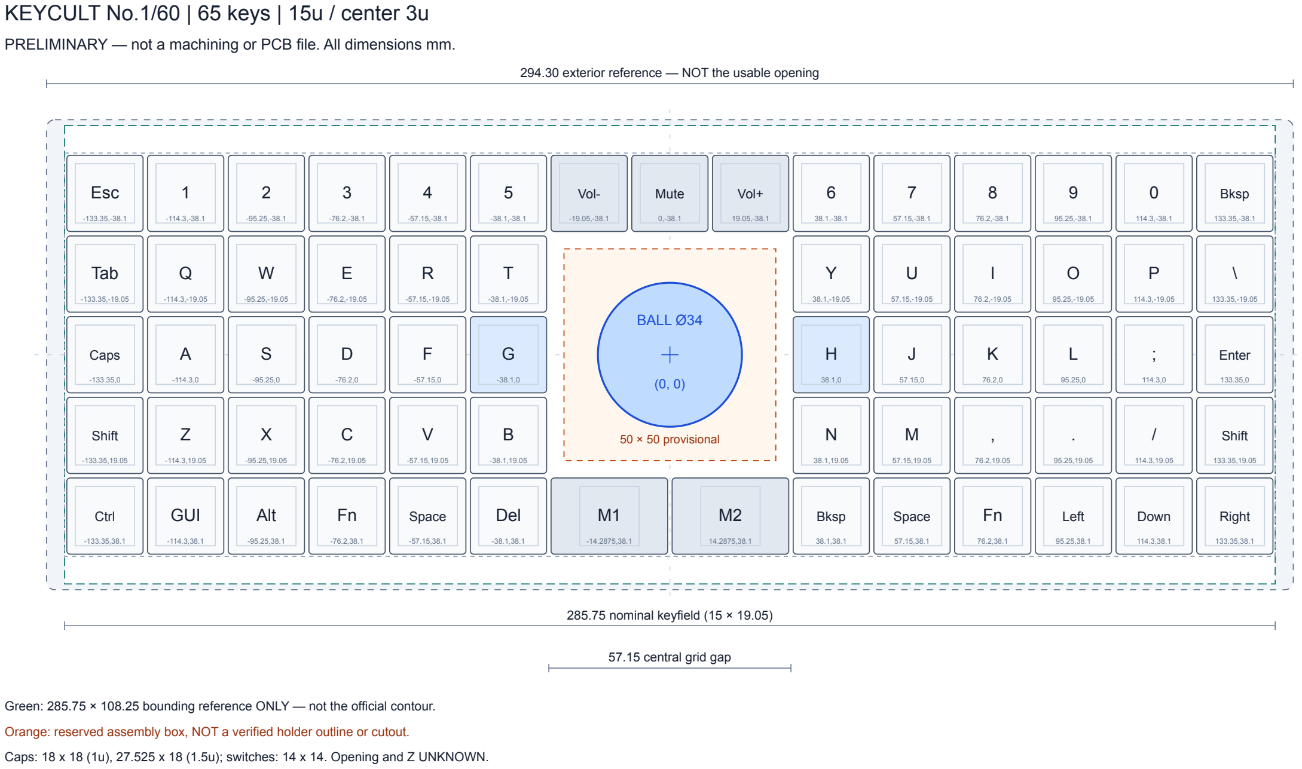
[picture p6: figure]
BALL Ø34; 50 × 50 provisional; Esc; Vol-; Mute; Vol+; Bksp; Tab; Caps; Enter; Shift; Ctrl; GUI; Alt; Space; Del; Left; Down; Right; 285.75 nominal keyfield (15 × 19.05); 57.15 central grid gap

# KEYCULT No.1/60 | 65 keys | 15u / center 3u

PRELIMINARY — not a machining or PCB file. All dimensions mm.

# 294.30 exterior reference — NOT the usable opening

Green: 285.75 × 108.25 bounding reference ONLY — not the official contour.

Orange: reserved assembly box, NOT a verified holder outline or cutout.

Caps: 18 x 18 (1u), 27.525 x 18 (1.5u); switches: 14 x 14. Opening and Z UNKNOWN.

# 100 mm calibration — print at 100%
