gytkk/keycult-ball/design/pcb/exports/schematic.pdf

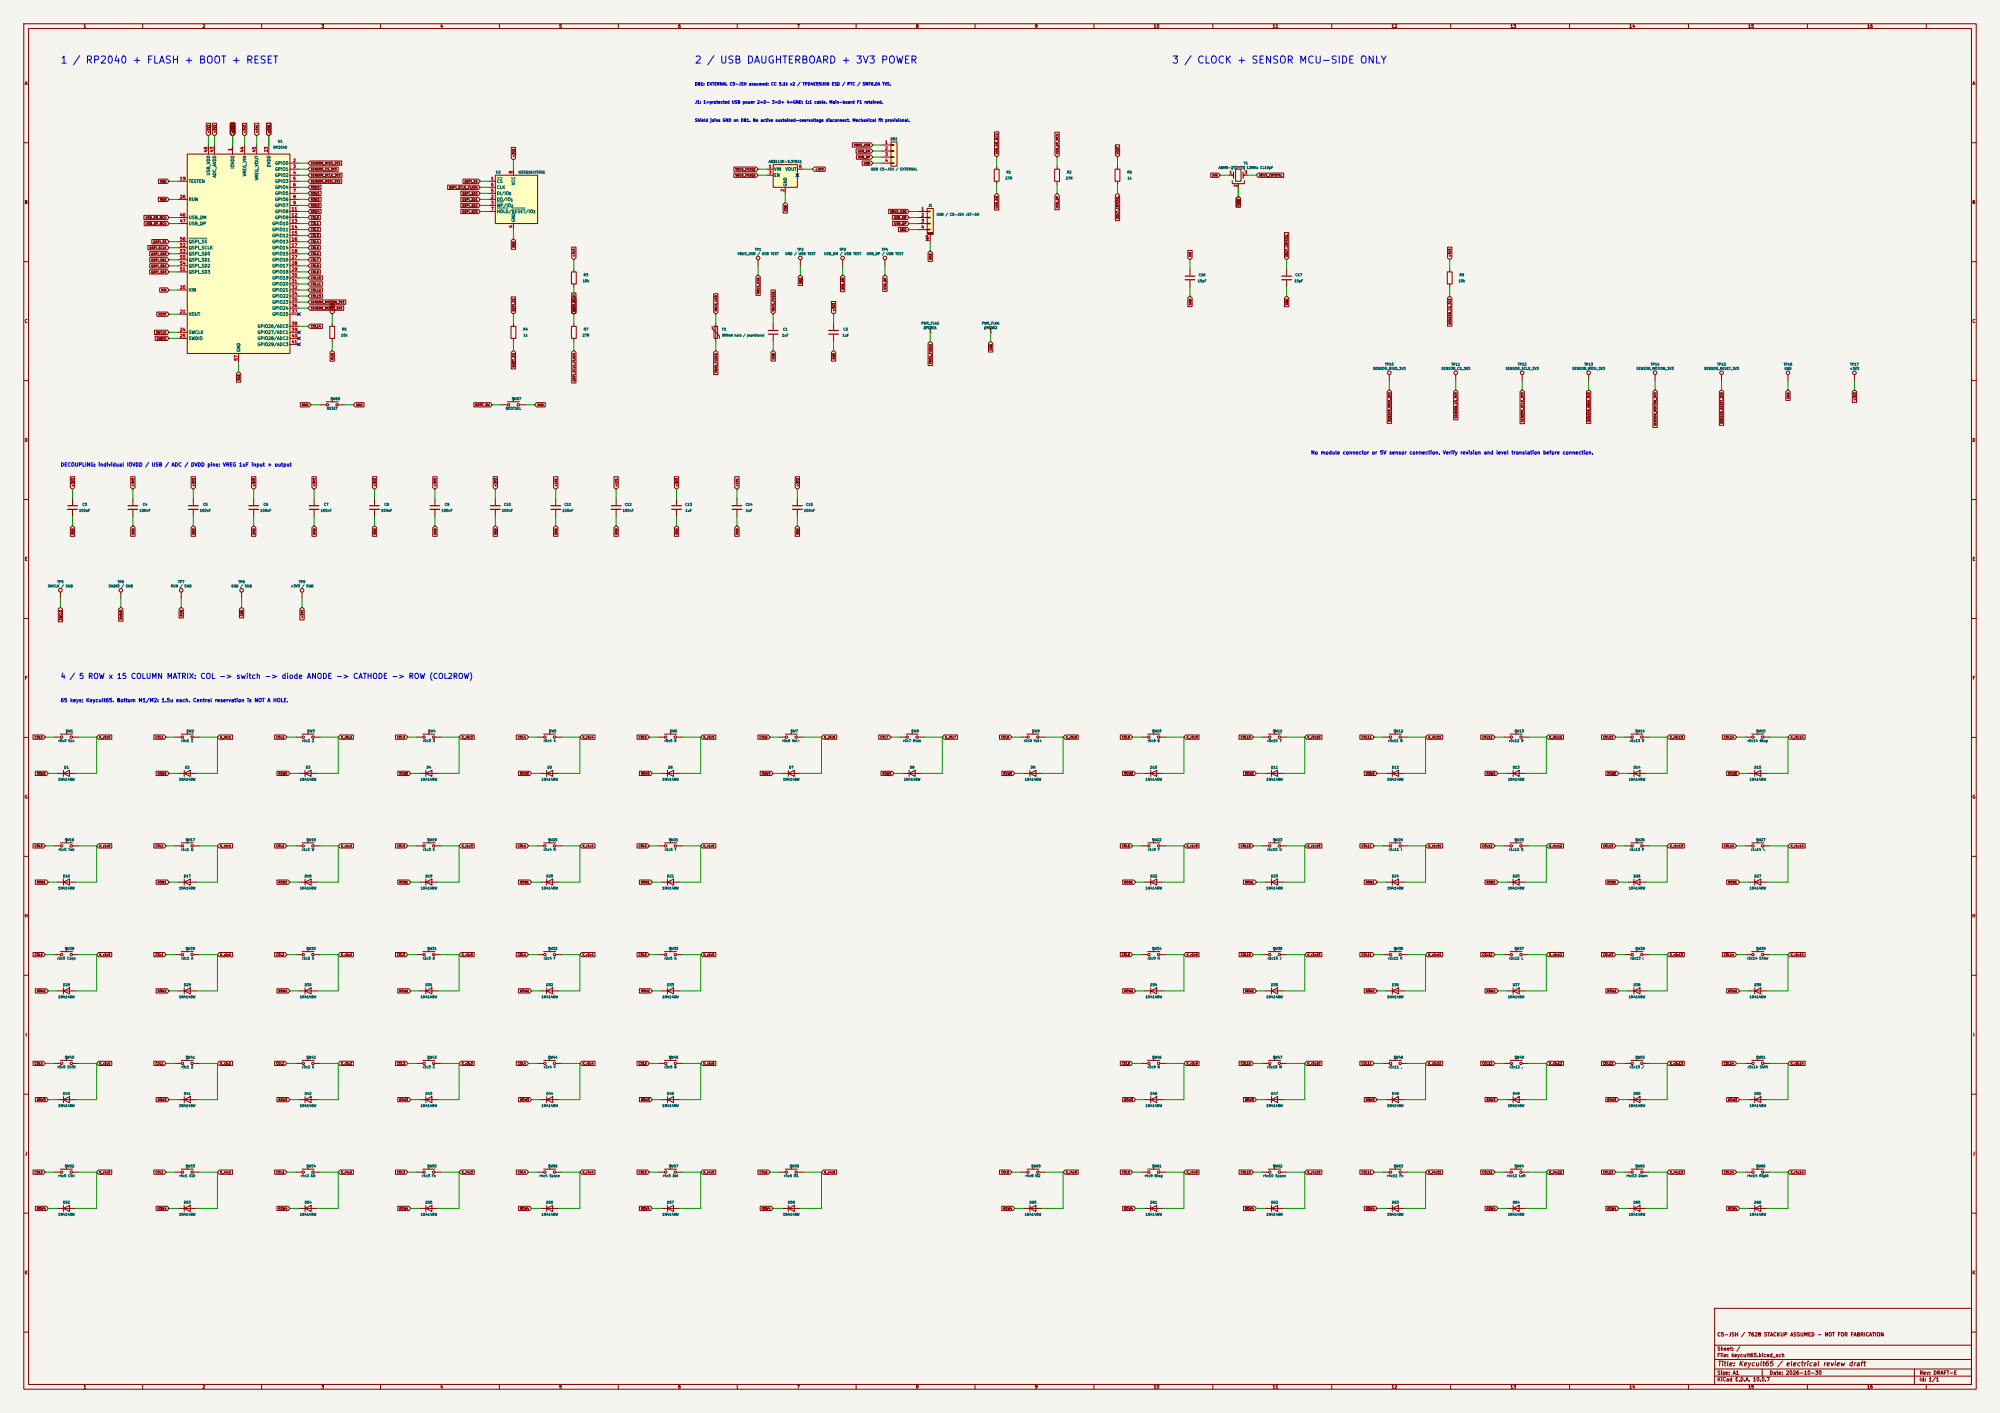
[picture p8: page 1]

DB1: EXTERNAL C5-JSH assumed; CC 5.1k x2 / TPD4E05U06 ESD / PTC / SMF6.0A TVS.

4 DI/IO0 5 CLK 6 HOLD/RESET/IO3 7 VCC

No module connector or 5V sensor connection. Verify revision and level translation before connection.

DECOUPLING: individual IOVDD / USB / ADC / DVDD pins; VREG 1uF input + output

4 / 5 ROW x 15 COLUMN MATRIX: COL -> switch -> diode ANODE -> CATHODE -> ROW (COL2ROW)

65 keys; Keycult65. Bottom M1/M2: 1.5u each. Central reservation is NOT A HOLE.

C5-JSH / 7628 STACKUP ASSUMED - NOT FOR FABRICATION

Sheet: /
File: keycult65.kicad_sch
Title: Keycult65 / electrical review draft

Size: A1 | Rev: DRAFT-E
KiCad E.D.A. 10.0.7 | Id: 1/1
