gytkk/keycult-ball/design/pcb/62/exports/schematic.pdf

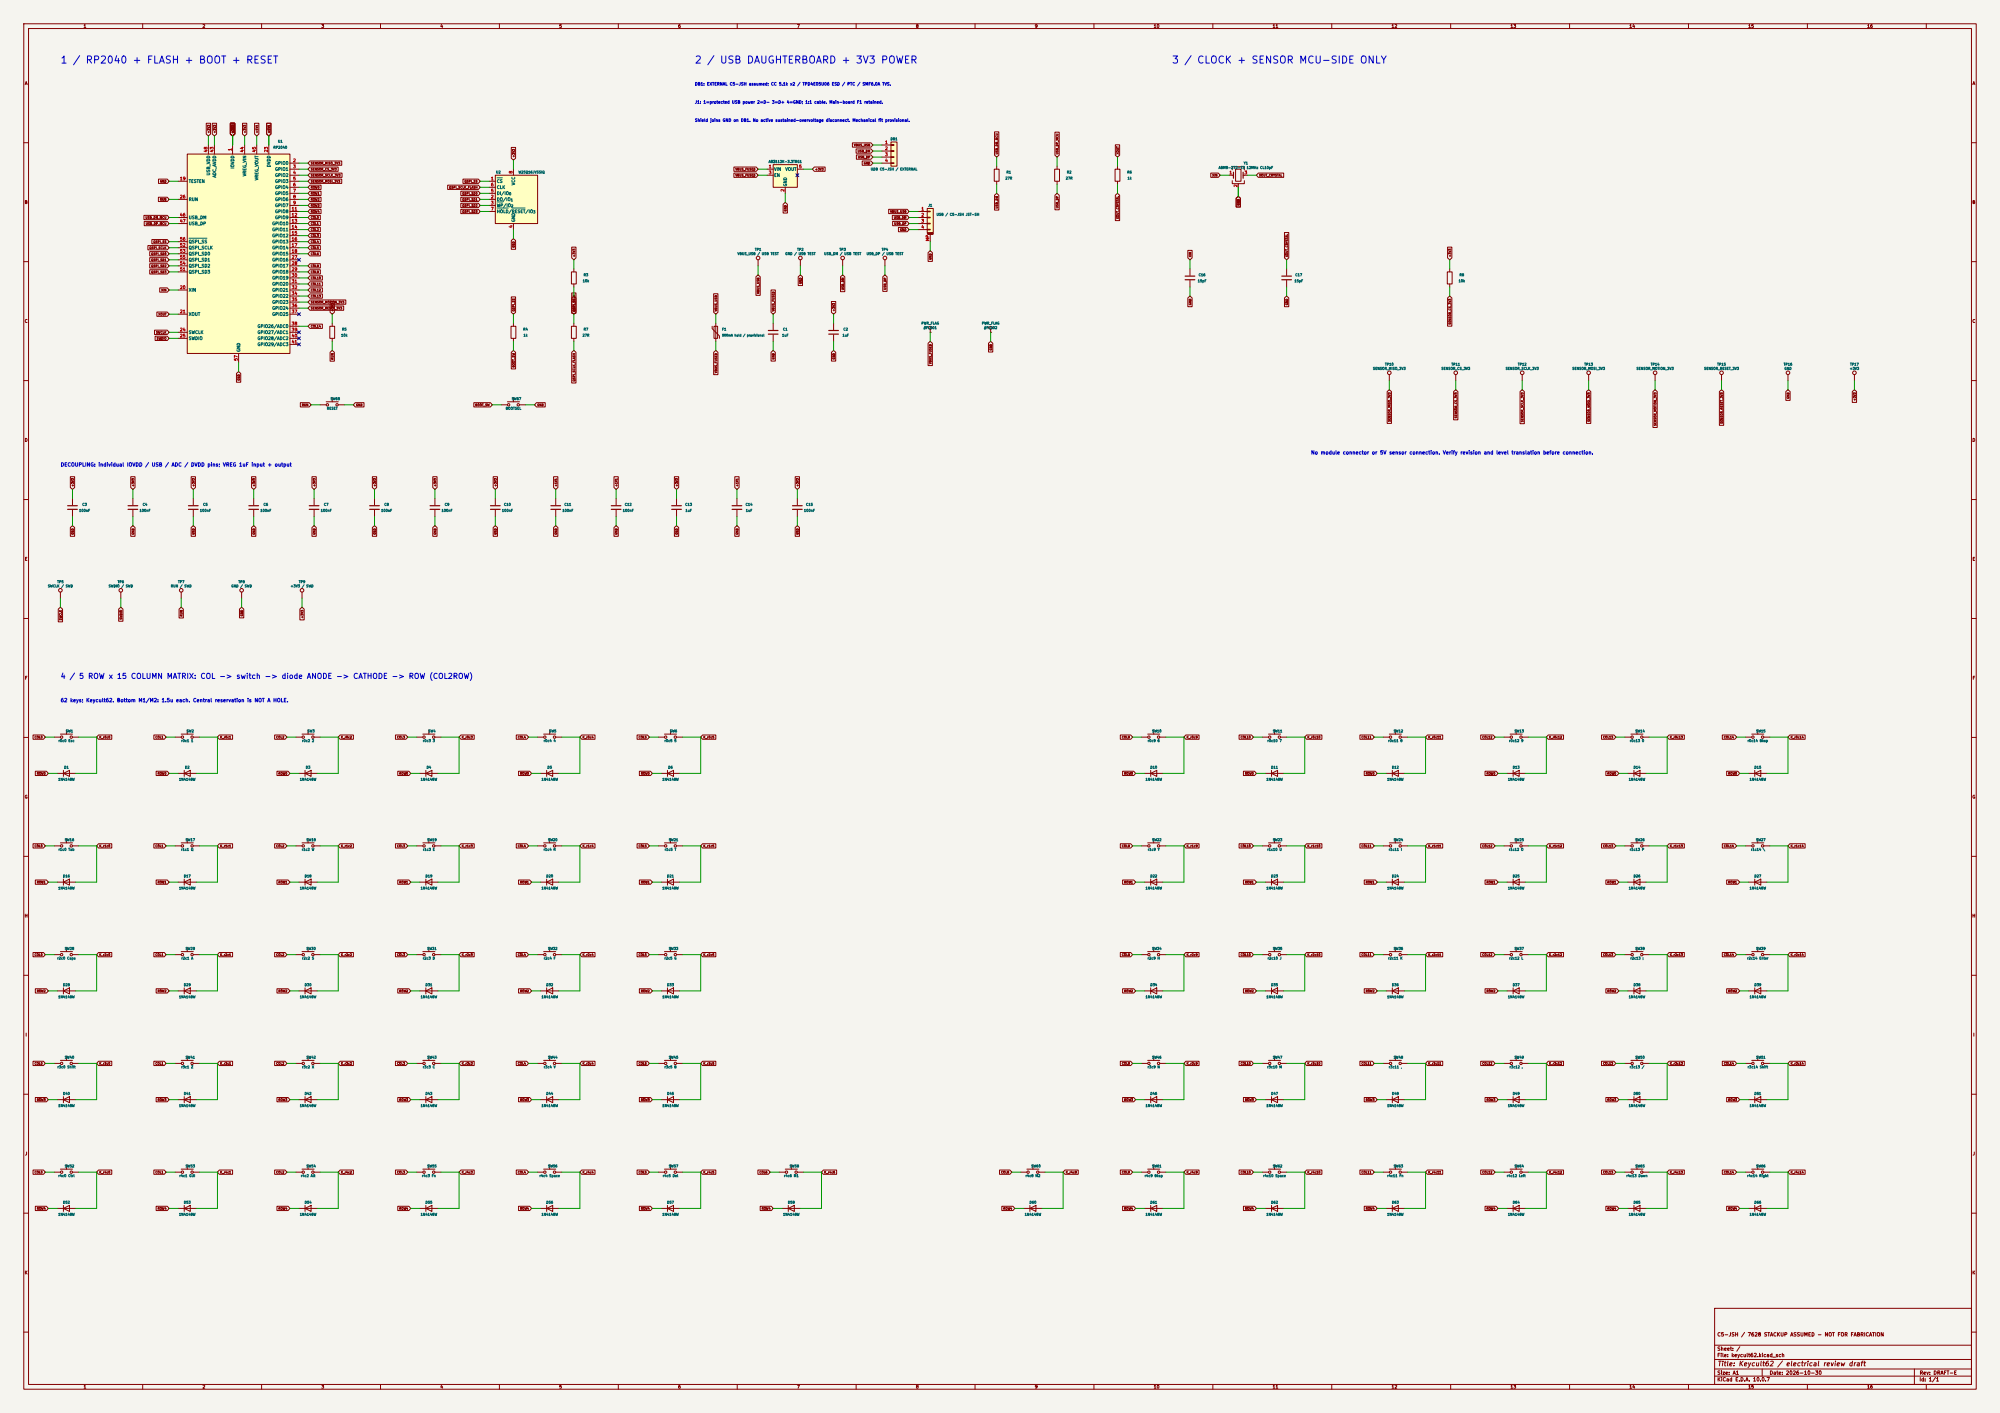
[picture p9: page 1]

DB1: EXTERNAL C5-JSH assumed; CC 5.1k x2 / TPD4E05U06 ESD / PTC / SMF6.0A TVS. J1: 1=protected USB power 2=D- 3=D+ 4=GND; 1:1 cable. Main-board F1 retained. DECOUPLING: individual IOVDD / USB / ADC / DVDD pins; VREG 1uF input + output

Shield joins GND on DB1. No active sustained-overvoltage disconnect. Mechanical fit provisional.

4 DI/IO0 5 CLK 6 HOLD/RESET/IO3 7 VCC

No module connector or 5V sensor connection. Verify revision and level translation before connection.

4 / 5 ROW x 15 COLUMN MATRIX: COL -> switch -> diode ANODE -> CATHODE -> ROW (COL2ROW)

62 keys; Keycult62. Bottom M1/M2: 1.5u each. Central reservation is NOT A HOLE.

C5-JSH / 7628 STACKUP ASSUMED - NOT FOR FABRICATION

Sheet: /
File: keycult62.kicad_sch
Title: Keycult62 / electrical review draft

Size: A1 | Rev: DRAFT-E
KiCad E.D.A. 10.0.7 | Id: 1/1
