gytkk/keycult-ball/design/pcb/keycult65.kicad_pcb

## KiCad design design/pcb/keycult65.kicad_pcb (2026-10-30)

Schematic: keycult65.kicad_sch, Keycult65 / electrical review draft

Parts:
C1, C2: 1uF; C_0603_1608Metric
C3, C4, C5, C6, C7, C8, C9, C10, C11, C12, C15: 100nF; C_0402_1005Metric
C13, C14: 1uF; C_0402_1005Metric
C16, C17: 15pF; C_0402_1005Metric
D1, D2, D3, D4, D5, D6, D7, D8, D9, D10, D11, D12, D13, D14, D15, D16, D17, D18, D19, D20, D21, D22, D23, D24, D25, D26, D27, D28, D29, D30, D31, D32, D33, D34, D35, D36, D37, D38, D39, D40, D41, D42, D43, D44, D45, D46, D47, D48, D49, D50, D51, D52, D53, D54, D55, D56, D57, D58, D60, D61, D62, D63, D64, D65, D66: 1N4148W; D_SOD-123
DB1: UDB C5-JSH / EXTERNAL
F1: 500mA hold / provisional; Fuse_0805_2012Metric
J1: USB / C5-JSH JST-SH; JST_SH_SM04B-SRSS-TB_1x04-1MP_P1.00mm_Horizontal
R1, R2, R7: 27R; R_0402_1005Metric
R3, R5, R8: 10k; R_0402_1005Metric
R4, R6: 1k; R_0402_1005Metric
SW1: r0c0 Esc; SW_Cherry_MX_1.00u_PCB
SW2: r0c1 1; SW_Cherry_MX_1.00u_PCB
SW3: r0c2 2; SW_Cherry_MX_1.00u_PCB
SW4: r0c3 3; SW_Cherry_MX_1.00u_PCB
SW5: r0c4 4; SW_Cherry_MX_1.00u_PCB
SW6: r0c5 5; SW_Cherry_MX_1.00u_PCB
SW7: r0c6 Vol-; SW_Cherry_MX_1.00u_PCB
SW8: r0c7 Mute; SW_Cherry_MX_1.00u_PCB
SW9: r0c8 Vol+; SW_Cherry_MX_1.00u_PCB
SW10: r0c9 6; SW_Cherry_MX_1.00u_PCB
SW11: r0c10 7; SW_Cherry_MX_1.00u_PCB
SW12: r0c11 8; SW_Cherry_MX_1.00u_PCB
SW13: r0c12 9; SW_Cherry_MX_1.00u_PCB
SW14: r0c13 0; SW_Cherry_MX_1.00u_PCB
SW15: r0c14 Bksp; SW_Cherry_MX_1.00u_PCB
SW16: r1c0 Tab; SW_Cherry_MX_1.00u_PCB
SW17: r1c1 Q; SW_Cherry_MX_1.00u_PCB
SW18: r1c2 W; SW_Cherry_MX_1.00u_PCB
SW19: r1c3 E; SW_Cherry_MX_1.00u_PCB
SW20: r1c4 R; SW_Cherry_MX_1.00u_PCB
SW21: r1c5 T; SW_Cherry_MX_1.00u_PCB
SW22: r1c9 Y; SW_Cherry_MX_1.00u_PCB
SW23: r1c10 U; SW_Cherry_MX_1.00u_PCB
SW24: r1c11 I; SW_Cherry_MX_1.00u_PCB
SW25: r1c12 O; SW_Cherry_MX_1.00u_PCB
SW26: r1c13 P; SW_Cherry_MX_1.00u_PCB
SW27: r1c14 \; SW_Cherry_MX_1.00u_PCB
SW28: r2c0 Caps; SW_Cherry_MX_1.00u_PCB
SW29: r2c1 A; SW_Cherry_MX_1.00u_PCB
SW30: r2c2 S; SW_Cherry_MX_1.00u_PCB
SW31: r2c3 D; SW_Cherry_MX_1.00u_PCB
SW32: r2c4 F; SW_Cherry_MX_1.00u_PCB
SW33: r2c5 G; SW_Cherry_MX_1.00u_PCB
SW34: r2c9 H; SW_Cherry_MX_1.00u_PCB
SW35: r2c10 J; SW_Cherry_MX_1.00u_PCB
SW36: r2c11 K; SW_Cherry_MX_1.00u_PCB
SW37: r2c12 L; SW_Cherry_MX_1.00u_PCB
SW38: r2c13 ;; SW_Cherry_MX_1.00u_PCB
SW39: r2c14 Enter; SW_Cherry_MX_1.00u_PCB
SW40: r3c0 Shift; SW_Cherry_MX_1.00u_PCB
SW41: r3c1 Z; SW_Cherry_MX_1.00u_PCB
SW42: r3c2 X; SW_Cherry_MX_1.00u_PCB
SW43: r3c3 C; SW_Cherry_MX_1.00u_PCB
SW44: r3c4 V; SW_Cherry_MX_1.00u_PCB
SW45: r3c5 B; SW_Cherry_MX_1.00u_PCB
SW46: r3c9 N; SW_Cherry_MX_1.00u_PCB
SW47: r3c10 M; SW_Cherry_MX_1.00u_PCB
SW48: r3c11 ,; SW_Cherry_MX_1.00u_PCB
SW49: r3c12 .; SW_Cherry_MX_1.00u_PCB
SW50: r3c13 /; SW_Cherry_MX_1.00u_PCB
SW51: r3c14 Shift; SW_Cherry_MX_1.00u_PCB
SW52: r4c0 Ctrl; SW_Cherry_MX_1.00u_PCB
SW53: r4c1 GUI; SW_Cherry_MX_1.00u_PCB
SW54: r4c2 Alt; SW_Cherry_MX_1.00u_PCB
SW55: r4c3 Fn; SW_Cherry_MX_1.00u_PCB
SW56: r4c4 Space; SW_Cherry_MX_1.00u_PCB
SW57: r4c5 Del; SW_Cherry_MX_1.00u_PCB
SW58: r4c6 M1; SW_Cherry_MX_1.50u_PCB
SW60: r4c8 M2; SW_Cherry_MX_1.50u_PCB
SW61: r4c9 Bksp; SW_Cherry_MX_1.00u_PCB
SW62: r4c10 Space; SW_Cherry_MX_1.00u_PCB
SW63: r4c11 Fn; SW_Cherry_MX_1.00u_PCB
SW64: r4c12 Left; SW_Cherry_MX_1.00u_PCB
SW65: r4c13 Down; SW_Cherry_MX_1.00u_PCB
SW66: r4c14 Right; SW_Cherry_MX_1.00u_PCB
SW67: BOOTSEL; SW_SPST_TL3342
SW68: RESET; SW_SPST_TL3342
TP1: VBUS_USB / USB TEST; TestPoint_Pad_D1.5mm
TP2: GND / USB TEST; TestPoint_Pad_D1.5mm
TP3: USB_DM / USB TEST; TestPoint_Pad_D1.5mm
TP4: USB_DP / USB TEST; TestPoint_Pad_D1.5mm
TP5: SWCLK / SWD; TestPoint_Pad_D1.0mm
TP6: SWDIO / SWD; TestPoint_Pad_D1.0mm
TP7: RUN / SWD; TestPoint_Pad_D1.0mm
TP8: GND / SWD; TestPoint_Pad_D1.0mm
TP9: +3V3 / SWD; TestPoint_Pad_D1.0mm
TP10: SENSOR_MISO_3V3; TestPoint_Pad_D1.0mm
TP11: SENSOR_CS_3V3; TestPoint_Pad_D1.0mm
TP12: SENSOR_SCLK_3V3; TestPoint_Pad_D1.0mm
TP13: SENSOR_MOSI_3V3; TestPoint_Pad_D1.0mm
TP14: SENSOR_MOTION_3V3; TestPoint_Pad_D1.0mm
TP15: SENSOR_RESET_3V3; TestPoint_Pad_D1.0mm
TP16: GND; TestPoint_Pad_D1.0mm
TP17: +3V3; TestPoint_Pad_D1.0mm
U1: RP2040; QFN-56-1EP_7x7mm_P0.4mm_EP3.2x3.2mm
U2: W25Q16JVSSIQ; SOIC-8_5.3x5.3mm_P1.27mm
U3: AP2112K-3.3TRG1; SOT-23-5
Y1: ABM8-272-T3 12MHz CL10pF; Crystal_SMD_3225-4Pin_3.2x2.5mm

Connections:
+1V1: C11.1, C12.1, C14.1, U1.23 (DVDD), U1.45 (VREG_VOUT), U1.50 (DVDD)
+3V3: C2.1, C3.1, C4.1, C5.1, C6.1, C7.1, C8.1, C9.1, C10.1, C13.1, C15.1, R3.1, R5.1, R8.1, TP9.1, TP17.1, U1.1 (IOVDD), U1.10 (IOVDD), U1.22 (IOVDD), U1.33 (IOVDD), U1.42 (IOVDD), U1.43 (ADC_AVDD), U1.44 (VREG_VIN), U1.48 (USB_VDD), U1.49 (IOVDD), U2.8 (VCC), U3.5 (VOUT)
BOOT_SW: R4.2, SW67.1
COL0: SW1.1, SW16.1, SW28.1, SW40.1, SW52.1, U1.12 (GPIO9)
COL1: SW2.1, SW17.1, SW29.1, SW41.1, SW53.1, U1.13 (GPIO10)
COL2: SW3.1, SW18.1, SW30.1, SW42.1, SW54.1, U1.14 (GPIO11)
COL3: SW4.1, SW19.1, SW31.1, SW43.1, SW55.1, U1.15 (GPIO12)
COL4: SW5.1, SW20.1, SW32.1, SW44.1, SW56.1, U1.16 (GPIO13)
COL5: SW6.1, SW21.1, SW33.1, SW45.1, SW57.1, U1.17 (GPIO14)
COL6: SW7.1, SW58.1, U1.18 (GPIO15)
COL7: SW8.1, U1.27 (GPIO16)
COL8: SW9.1, SW60.1, U1.28 (GPIO17)
COL9: SW10.1, SW22.1, SW34.1, SW46.1, SW61.1, U1.29 (GPIO18)
COL10: SW11.1, SW23.1, SW35.1, SW47.1, SW62.1, U1.30 (GPIO19)
COL11: SW12.1, SW24.1, SW36.1, SW48.1, SW63.1, U1.31 (GPIO20)
COL12: SW13.1, SW25.1, SW37.1, SW49.1, SW64.1, U1.32 (GPIO21)
COL13: SW14.1, SW26.1, SW38.1, SW50.1, SW65.1, U1.34 (GPIO22)
COL14: SW15.1, SW27.1, SW39.1, SW51.1, SW66.1, U1.38 (GPIO26/ADC0)
GND: C1.2, C2.2, C3.2, C4.2, C5.2, C6.2, C7.2, C8.2, C9.2, C10.2, C11.2, C12.2, C13.2, C14.2, C15.2, C16.2, C17.2, DB1.4, J1.4, J1.MP (MountPin), SW67.2, SW68.2, TP2.1, TP8.1, TP16.1, U1.19 (TESTEN), U1.57 (GND), U2.4 (GND), U3.2 (GND), Y1.2 (G), Y1.4 (G)
K_r0c0: D1.2 (A), SW1.2
K_r0c1: D2.2 (A), SW2.2
K_r0c2: D3.2 (A), SW3.2
K_r0c3: D4.2 (A), SW4.2
K_r0c4: D5.2 (A), SW5.2
K_r0c5: D6.2 (A), SW6.2
K_r0c6: D7.2 (A), SW7.2
K_r0c7: D8.2 (A), SW8.2
K_r0c8: D9.2 (A), SW9.2
K_r0c9: D10.2 (A), SW10.2
K_r0c10: D11.2 (A), SW11.2
K_r0c11: D12.2 (A), SW12.2
K_r0c12: D13.2 (A), SW13.2
K_r0c13: D14.2 (A), SW14.2
K_r0c14: D15.2 (A), SW15.2
K_r1c0: D16.2 (A), SW16.2
K_r1c1: D17.2 (A), SW17.2
K_r1c2: D18.2 (A), SW18.2
K_r1c3: D19.2 (A), SW19.2
K_r1c4: D20.2 (A), SW20.2
K_r1c5: D21.2 (A), SW21.2
K_r1c9: D22.2 (A), SW22.2
K_r1c10: D23.2 (A), SW23.2
K_r1c11: D24.2 (A), SW24.2
K_r1c12: D25.2 (A), SW25.2
K_r1c13: D26.2 (A), SW26.2
K_r1c14: D27.2 (A), SW27.2
K_r2c0: D28.2 (A), SW28.2
K_r2c1: D29.2 (A), SW29.2
K_r2c2: D30.2 (A), SW30.2
K_r2c3: D31.2 (A), SW31.2
K_r2c4: D32.2 (A), SW32.2
K_r2c5: D33.2 (A), SW33.2
K_r2c9: D34.2 (A), SW34.2
K_r2c10: D35.2 (A), SW35.2
K_r2c11: D36.2 (A), SW36.2
K_r2c12: D37.2 (A), SW37.2
K_r2c13: D38.2 (A), SW38.2
K_r2c14: D39.2 (A), SW39.2
K_r3c0: D40.2 (A), SW40.2
K_r3c1: D41.2 (A), SW41.2
K_r3c2: D42.2 (A), SW42.2
K_r3c3: D43.2 (A), SW43.2
K_r3c4: D44.2 (A), SW44.2
K_r3c5: D45.2 (A), SW45.2
K_r3c9: D46.2 (A), SW46.2
K_r3c10: D47.2 (A), SW47.2
K_r3c11: D48.2 (A), SW48.2
K_r3c12: D49.2 (A), SW49.2
K_r3c13: D50.2 (A), SW50.2
K_r3c14: D51.2 (A), SW51.2
K_r4c0: D52.2 (A), SW52.2
K_r4c1: D53.2 (A), SW53.2
K_r4c2: D54.2 (A), SW54.2
K_r4c3: D55.2 (A), SW55.2
K_r4c4: D56.2 (A), SW56.2
K_r4c5: D57.2 (A), SW57.2
K_r4c6: D58.2 (A), SW58.2
K_r4c8: D60.2 (A), SW60.2
K_r4c9: D61.2 (A), SW61.2
K_r4c10: D62.2 (A), SW62.2
K_r4c11: D63.2 (A), SW63.2
K_r4c12: D64.2 (A), SW64.2
K_r4c13: D65.2 (A), SW65.2
K_r4c14: D66.2 (A), SW66.2
QSPI_SCLK: R7.1, U1.52 (QSPI_SCLK)
QSPI_SCLK_FLASH: R7.2, U2.6 (CLK)
QSPI_SD0: U1.53 (QSPI_SD0), U2.5 (DI/IO_{0})
QSPI_SD1: U1.55 (QSPI_SD1), U2.2 (DO/IO_{1})
QSPI_SD2: U1.54 (QSPI_SD2), U2.3 (~WP/IO_{2})
QSPI_SD3: U1.51 (QSPI_SD3), U2.7 (~HOLD/~RESET/IO_{3})
QSPI_SS: R3.2, R4.1, U1.56 (~QSPI_SS), U2.1 (~CS)
ROW0: D1.1 (K), D2.1 (K), D3.1 (K), D4.1 (K), D5.1 (K), D6.1 (K), D7.1 (K), D8.1 (K), D9.1 (K), D10.1 (K), D11.1 (K), D12.1 (K), D13.1 (K), D14.1 (K), D15.1 (K), U1.6 (GPIO4)
ROW1: D16.1 (K), D17.1 (K), D18.1 (K), D19.1 (K), D20.1 (K), D21.1 (K), D22.1 (K), D23.1 (K), D24.1 (K), D25.1 (K), D26.1 (K), D27.1 (K), U1.7 (GPIO5)
ROW2: D28.1 (K), D29.1 (K), D30.1 (K), D31.1 (K), D32.1 (K), D33.1 (K), D34.1 (K), D35.1 (K), D36.1 (K), D37.1 (K), D38.1 (K), D39.1 (K), U1.8 (GPIO6)
ROW3: D40.1 (K), D41.1 (K), D42.1 (K), D43.1 (K), D44.1 (K), D45.1 (K), D46.1 (K), D47.1 (K), D48.1 (K), D49.1 (K), D50.1 (K), D51.1 (K), U1.9 (GPIO7)
ROW4: D52.1 (K), D53.1 (K), D54.1 (K), D55.1 (K), D56.1 (K), D57.1 (K), D58.1 (K), D60.1 (K), D61.1 (K), D62.1 (K), D63.1 (K), D64.1 (K), D65.1 (K), D66.1 (K), U1.11 (GPIO8)
RUN: R5.2, SW68.1, TP7.1, U1.26 (RUN)
SENSOR_CS_3V3: R8.2, TP11.1, U1.3 (GPIO1)
SENSOR_MISO_3V3: TP10.1, U1.2 (GPIO0)
SENSOR_MOSI_3V3: TP13.1, U1.5 (GPIO3)
SENSOR_MOTION_3V3: TP14.1, U1.35 (GPIO23)
SENSOR_RESET_3V3: TP15.1, U1.36 (GPIO24)
SENSOR_SCLK_3V3: TP12.1, U1.4 (GPIO2)
SWCLK: TP5.1, U1.24 (SWCLK)
SWDIO: TP6.1, U1.25 (SWDIO)
USB_DM: DB1.2, J1.2, R1.2, TP3.1
USB_DM_MCU: R1.1, U1.46 (USB_DM)
USB_DP: DB1.3, J1.3, R2.2, TP4.1
USB_DP_MCU: R2.1, U1.47 (USB_DP)
VBUS_FUSED: C1.1, F1.2, U3.1 (VIN), U3.3 (EN)
VBUS_USB: DB1.1, F1.1, J1.1, TP1.1
XIN: C16.1, U1.20 (XIN), Y1.1
XOUT: R6.1, U1.21 (XOUT)
XOUT_CRYSTAL: C17.1, R6.2, Y1.3

Notes on the sheet:
1 / RP2040 + FLASH + BOOT + RESET
2 / USB DAUGHTERBOARD + 3V3 POWER
3 / CLOCK + SENSOR MCU-SIDE ONLY
No module connector or 5V sensor connection. Verify revision and level translation before connection.
DECOUPLING: individual IOVDD / USB / ADC / DVDD pins; VREG 1uF input + output
4 / 5 ROW x 15 COLUMN MATRIX: COL -> switch -> diode ANODE -> CATHODE -> ROW (COL2ROW)
65 keys; Keycult65. Bottom M1/M2: 1.5u each. Central reservation is NOT A HOLE.
DB1: EXTERNAL C5-JSH assumed; CC 5.1k x2 / TPD4E05U06 ESD / PTC / SMF6.0A TVS.
J1: 1=protected USB power 2=D- 3=D+ 4=GND; 1:1 cable. Main-board F1 retained.
Shield joins GND on DB1. No active sustained-overvoltage disconnect. Mechanical fit provisional.

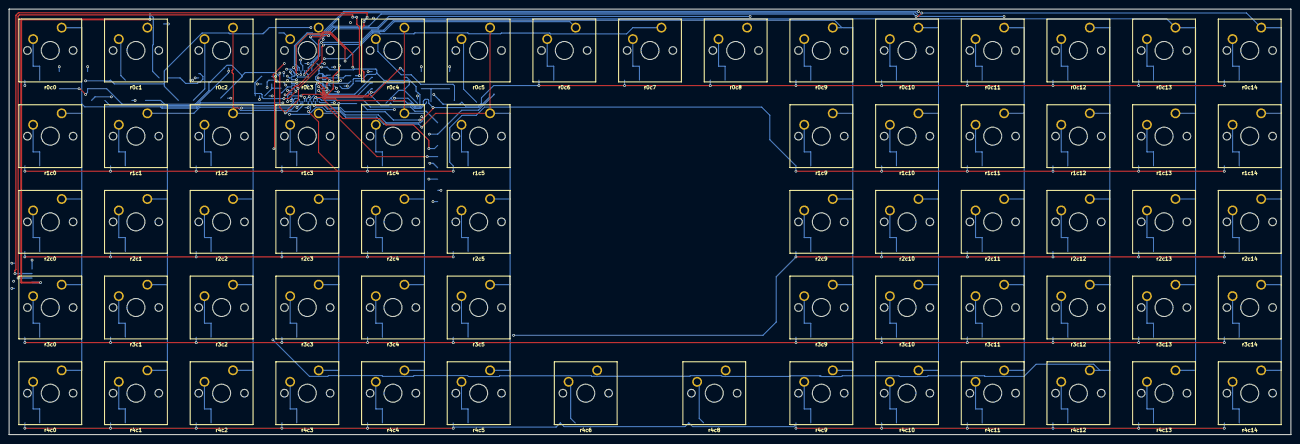
[picture p22: board keycult65.kicad_pcb from above]

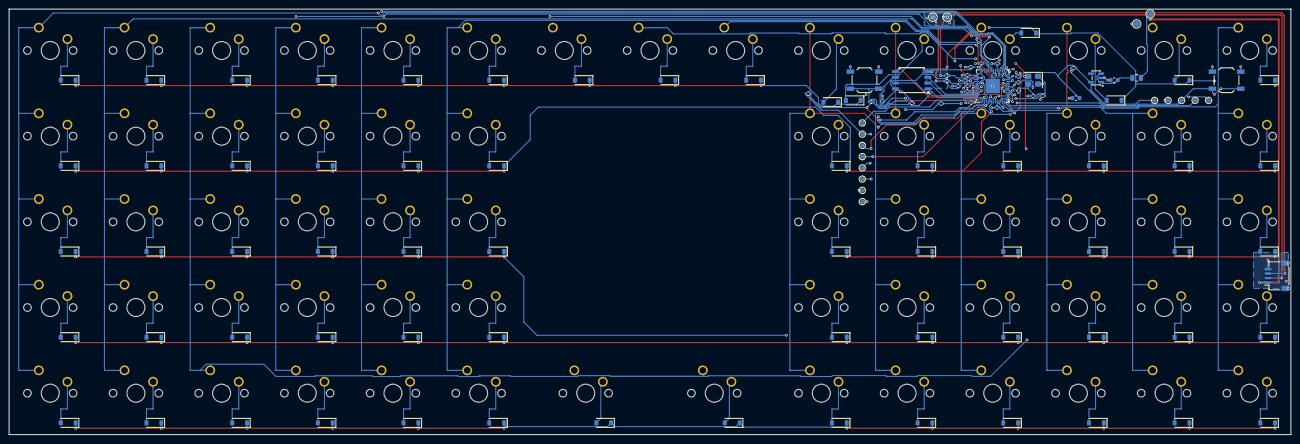
[picture p23: board keycult65.kicad_pcb from below]

Board: 4 copper layers, 285.0 x 94.6 mm, 180 parts (115 on the bottom side), 114 nets.
