gytkk/keycult-ball/(commit log)

2026-10-29 docs: assess central pointing device feasibility and alternatives
2026-10-29 docs: require central pointing device integration
2026-10-29 feat: add rear clearance trackball layout option
    [render.py, validate.py]
2026-10-29 docs: record GH60 PCB design starting point
2026-10-29 docs: plan PCB implementation ahead of case measurements
2026-10-29 feat(pcb): add reviewable 66-key KiCad schematic and partial routing draft
    [bom.csv, gpio-map.csv, keycult66.kicad_pcb, keycult66.kicad_sch]
2026-10-29 docs: research modular 34mm trackballs and scroll rings
2026-10-29 feat(pcb): complete internal routing for 66-key and 63-key variants
    [bom.csv, gpio-map.csv, keycult63.kicad_pcb, keycult63.kicad_sch, keycult66.kicad_pcb, keycult66.kicad_sch]
2026-10-29 feat(pcb): add UDB interface and record paused design checkpoint
    [bom.csv, keycult63.kicad_pcb, keycult63.kicad_sch, keycult66.kicad_pcb, keycult66.kicad_sch]
2026-10-30 docs(pcb): record resumed UDB routing review
2026-10-30 docs(pcb): verify WT-compatible daughterboard protection
2026-10-30 feat(pcb): adopt external C5-JSH daughterboard assumption
    [bom.csv, keycult63.kicad_pcb, keycult63.kicad_sch, keycult66.kicad_pcb, keycult66.kicad_sch]
2026-10-30 feat(pcb): add reproducible power and USB desk review
2026-10-30 feat(pcb): reroute USB over the ground reference
    Apply the candidate 7628 stackup and 0.29/0.20mm F.Cu pair to both variants. Add local ground stitching and preserve the existing power, matrix and MCU-side copper.
    Validate refilled reference coverage, strict ERC/DRC and saved-route replay. Refresh native exports and document the remaining impedance and hardware limits.
    [keycult63.kicad_pcb, keycult63.kicad_sch, keycult66.kicad_pcb, keycult66.kicad_sch]
2026-10-30 feat(mechanical): add local FreeCAD plate and carrier studies
2026-10-30 feat(pcb): use two 1.5u trackball buttons in both layouts
    [bom.csv, gpio-map.csv, keycult63.kicad_pcb, keycult63.kicad_sch, keycult66.kicad_pcb, keycult66.kicad_sch]
2026-10-30 refactor(cad): rename keyboard variants to 65 and 62 keys
    [bom.csv, gpio-map.csv, keycult62.kicad_pcb, keycult62.kicad_sch, keycult63.kicad_sch, keycult65.kicad_pcb, keycult65.kicad_sch, keycult66.kicad_sch]
